ElPudgino/LOS/README.md

# Система мониторинга аэрационной ЛОС

Проект направлен на создание прототипа системы мониторинга аэрационной станции биологической очистки сточных вод для загородного дома. Система должна контролировать поток воды в эрлифтах и давление в воздухных магистралях, передавать показания из станции в дом по радиоканалу, сохранять историю и заранее предупреждать о неполадках.

Главная задача — обнаруживать засоры эрлифтов, снижение производительности компрессоров и нарушение режимов работы до переполнения камер и ухудшения качества очистки. Проектная цель предусматривает автономный влагозащищённый измерительный блок в станции и домашний блок приёма, хранения и анализа данных.

Основное описание целей, требований и существующих аналогов: [scs-project-docs/project.md](scs-project-docs/project.md) и [PDF](scs-project-docs/project.pdf).

## Репозитории

### Документация

| Репозиторий | Назначение |
| --- | --- |
| [scs-project-docs](scs-project-docs/) | Цели и требования проекта, описание системы, обзор аналогов, схемы и проектное предложение. |
| [scs-docs](scs-docs/) | Справочные материалы: документация на микросхемы, датчики и модули, распиновки и другие технические материалы. |

### Прошивки и программное обеспечение

| Репозиторий | Назначение |
| --- | --- |
| [scs-ch32v003-sensor](scs-ch32v003-sensor/) | Bare-metal прошивка CH32V003 для ёмкостного датчика воды в эрлифте: RC-измерения, оценка изменчивости сигнала, энергосбережение и UART. |
| [scs-transmitter-fw-v1](scs-transmitter-fw-v1/) | Прошивка передатчика на Arduino Nano и CC1101: опрос трёх датчиков по UART, проверка CRC и передача измерений и ошибок по радиоканалу. |
| [scs-receiver-fw-v1](scs-receiver-fw-v1/) | Прошивка домашнего приёмника на Arduino Nano и CC1101: приём радиопакетов и выдача телеметрии на компьютер через USB-UART. |
| [scs-frontend](scs-frontend/) | Локальный сервис на Python/FastAPI и веб-интерфейс для сбора телеметрии, хранения истории в SQLite, графиков, статистики и диагностики. |
| [scs-air-valve-arduino](scs-air-valve-arduino/) | Прошивка контроллера воздушного клапана модели септика: управление сервоприводом по состоянию поплавкового датчика. |

### Платы, конструкции и стендовое оборудование

| Репозиторий | Назначение |
| --- | --- |
| [scs-water-sensor-ch32v003](scs-water-sensor-ch32v003/) | Схема и гибкая печатная плата ёмкостного датчика на CH32V003J4M6 с измерительной RC-цепью и интерфейсом UART/SWIO. |
| [scs-transmitter-pcb-v1](scs-transmitter-pcb-v1/) | Плата передатчика: Arduino Nano, CC1101, согласование уровней и подключение трёх датчиков. |
| [scs-receiver-pcb-v1](scs-receiver-pcb-v1/) | Плата приёмника: Arduino Nano, CC1101 и согласователь логических уровней. |
| [scs-air-valve-pcb](scs-air-valve-pcb/) | Плата контроллера воздушного клапана на Arduino Nano с подключением сервопривода, поплавка и питания. |
| [scs-stand-ps](scs-stand-ps/) | Изолированный трансформаторный блок питания стенда: схема, печатная плата и файлы для её изготовления. |
| [scs-3d-models](scs-3d-models/) | Корпуса, крепления и механические узлы датчиков и стенда; исходные 3D-модели и файлы для печати. |

### Инструменты разработки

| Репозиторий | Назначение |
| --- | --- |
| [scs-arduino-ch32v003-swio](scs-arduino-ch32v003-swio/) | Варианты адаптера UART–SWIO на ATmega328P для прошивки и отладки CH32V003 через minichlink. |
| [minichlink](minichlink/) | Сторонний инструмент для прошивки и отладки CH32V003 через WCH-LinkE, включая GDB-сервер и поддержку Ardulink. |
| [arduino-offline](arduino-offline/) | Локальный набор Arduino CLI, Arduino AVR Core и компилятора для автономной сборки Arduino-прошивок. |
