ElPudgino/LOS/scs-air-valve-pcb/README.md

# Контроллер воздушного клапана. Печатная плата

Плата выполнена в KiCAD. Схема в файле [air-valve-pcb.pdf](air-valve-pcb.pdf).

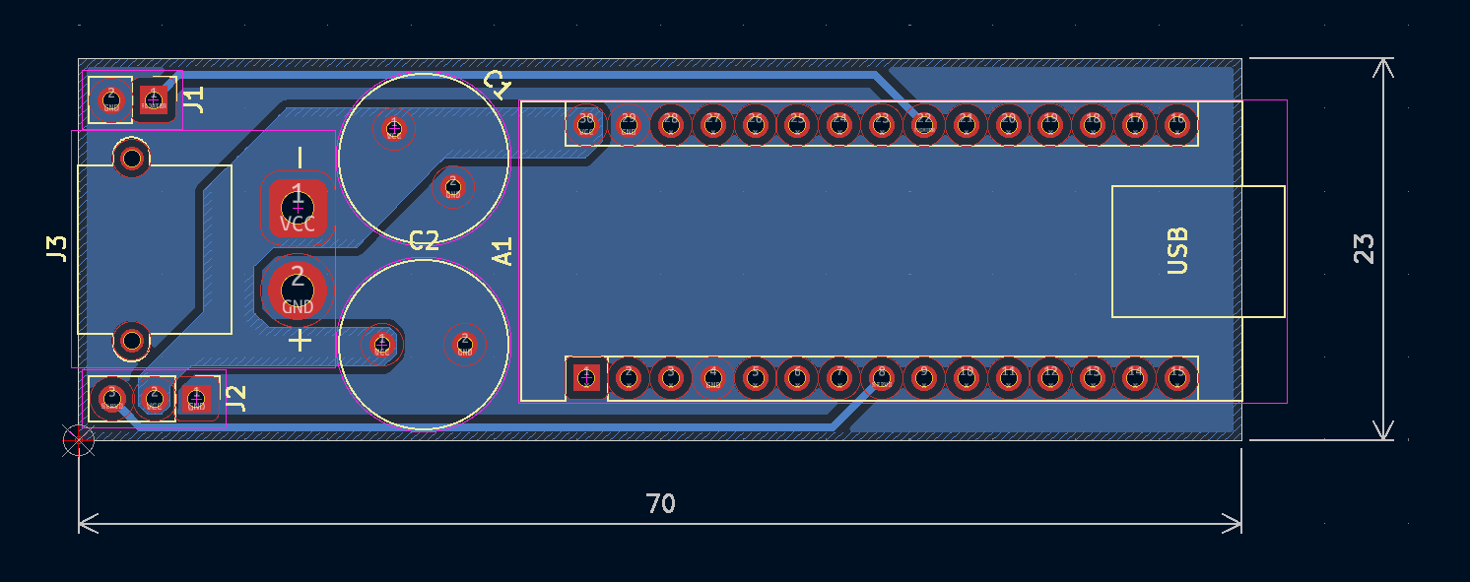
[picture p1: scs-air-valve-pcb/air-valve-pcb.png]
PCB
