ElPudgino/LOS/scs-receiver-fw-v1/README.md

# Приёмник телеметрии SCS

Приёмник SCS принимает в доме телеметрию от датчиков в аэрационной станции очистки сточных вод и передаёт её компьютеру для хранения и анализа.

Передатчик `scs-transmitter-fw-v1` по очереди опрашивает датчики и отправляет накопленные результаты и статусы ошибок по радио. Приёмник на Arduino Nano (ATmega328P) с радиомодулем CC1101 преобразует полученные данные в текст и выдаёт их через USB-подключение Nano.

После включения приёмник настраивает радио и накапливает корректные записи в порядке поступления. Когда в течение секунды нет новых корректных пакетов, он выдаёт накопленную группу между строками BEGIN и END. Так записи объединяются по паузе в передаче. 

Примерно раз в секунду прошивка отправляет строку BEAT, в том числе при недоступном радио. Это признак работы прошивки. При ошибке настройки или связи с радиомодулем приёмник повторяет инициализацию. Повреждённые пакеты и пакеты с неверным форматом отбрасываются целиком. При переполнении буфера вся накопленная группа заменяется сообщением об ошибке; после паузы приём следующей группы продолжается.

Сенсор, передатчик и приёмник должны использовать согласованный бинарный протокол и обновляться комплектом. Пауза между циклами передатчика должна позволять приёмнику разделять группы и завершать их вывод: во время вывода приём может терять пакеты. Повторной передачи и восстановления потерь нет, поэтому группа может быть неполной. Обмен с компьютером идёт по UART **115200, 8N1**; строки заканчиваются одним LF (без CR).

## Подключение

| Nano | CC1101 |
|---|---|
| D2 | GDO0 |
| D10  | CSN |
| D11  | MOSI |
| D12  | MISO |
| D13  | SCK |

Связь с компьютером идёт через штатный USB-UART Nano (D0/D1).

Радиопрофиль: кварц CC1101 26 МГц, 433,92 МГц, 2-FSK, 4,8 кбод, синхрослово D391, переменная длина. Предельный размер полезной нагрузки CC1101 (`Radio::PAYLOAD_SIZE`) составляет 32 байта.  Используется только штатная библиотека `SPI.h`.

## Бинарный радиопротокол

Каждая запись занимает ровно 6 байт и целиком находится в одном RF-пакете:

| Смещение | Поле |
|---|---|
| 0 | `H = (status << 4) | sensor` |
| 1 | `seq`, uint8_t |
| 2-5 | `value_milli`, uint32_t, big-endian |

Допустимые sensor: **1, 2, 3**. Пакет содержит 1-5 записей, то есть
**6, 12, 18, 24 или 30 байт**.

| status | Значение | Строка UART |
|---|---|---|
| 0 | Измерение | `<sensor> <SEQ> <integer>.<fraction>` |
| 1 | Нет ответа | `<sensor> ERR NR` |
| 2 | Таймаут | `<sensor> ERR TO` |
| 3 | Ошибка протокола/CRC сенсора | `<sensor> ERR CR` |
| 4 | Переполнение передатчика | `<sensor> ERR OF` |

У статусов 1-4 поля seq и value_milli игнорируются, даже если не нулевые (передатчик обязан заполнять их нулями). В измерениях SEQ выводится ровно двумя шестнадцатеричными цифрами в верхнем регистре. Значение форматируется целочисленно: `integer = value_milli / 1000`. Дробная часть содержит остаток, ровно три цифры. Числа с плавающей точкой, Arduino String и динамическая память не используются.

```text
01 0A 00 00 00 07  -> 1 0A 0.007
01 FF 00 00 03 E8  -> 1 FF 1.000
01 00 FF FF FF FF  -> 1 00 4294967.295
```

Перед изменением группы проверяется **весь физический RF-пакет**. Некратная 6 длина, неизвестный sensor или status приводят к отбрасыванию всего пакета, включая корректные записи до ошибки. Неизвестный H не превращается в CR: CR выдаётся только по явно полученному status 3. Пустые пакеты и пакеты с плохим аппаратным CRC также игнорируются. Программный CRC поверх радиозаписи не добавляется. Отклонённые пакеты не создают группу, не меняют её данные и не продлевают таймаут. Периодический BEAT и выдача группы по таймауту продолжают работать.

## Группировка, UART и доставка

- После 1000 мс без валидных непустых RF-пакетов группа выдаётся синхронно между `BEGIN\n` и `END\n`. Каждая запись даёт ровно одну строку; общий порядок записей и пакетов сохраняется. Пустая группа не выдаётся.
- На точной границе таймаута накопленная группа выдаётся до обработки нового пакета; новый валидный пакет начинает следующую группу.
- Независимо от состояния радио примерно раз в секунду выдаётся `BEAT\n` (первый через секунду после запуска). Он никогда не вставляется между BEGIN и END. SPI/UART могут немного задерживать BEAT.
- Буфер хранит только бинарные записи: **594 байта** = 3 сенсора * (32 измерения + 1 TO) * 6 байт. Ровно 594 байта принимаются, следующая шестибайтовая запись вызывает переполнение.
- При переполнении вся группа отбрасывается. Последующие валидные пакеты не сохраняются, но продлевают таймаут; протокольно невалидные его не продлевают.  После периода тишины выдаётся только `BEGIN\nERR BO\nEND\n`.  Следующая группа принимается нормально. BO означает переполнение приёмника, OF обозначает статус передатчика. Причиной BO может быть слияние циклов без необходимой паузы или несовпадение конфигураций.
- Переполнение RX FIFO и зависший пакет сбрасывают радиоприём. При ошибке готовности SPI или несовпадении прочитанных настроек инициализация повторяется с интервалом 1 с, без сообщений в UART. Накопленная группа завершается по таймауту.

Пример UART:

```text
BEAT
BEGIN
3 7E 0.117
3 7F 0.125
2 42 0.080
1 ERR NR
END
BEAT
```

## Конфигурация и сборка

Параметры `scs-receiver/config.h`: `BURST_TIMEOUT_MS=1000UL`, `BURST_BUFFER_SIZE=594`. Можно менять их через `EXTRA_FLAGS`.  Проверки при компиляции требуют положительный таймаут меньше 2^31 мс и положительный буфер, кратный 6 и помещающийся в uint16_t. Реальная ёмкость дополнительно ограничена SRAM ATmega328P; нужно оставлять место под стек.

Результаты сборок:

| FQBN | Flash (из 30720 байт) | Статическая SRAM (из 2048 байт) | Остаток под стек и локальные переменные |
|---|---|---|---|
| `arduino:avr:nano` | 4656 | 881 | 1167 |
| `arduino:avr:nano:cpu=atmega328old` | 4656 | 881 | 1167 |

Инструкция по установке зависимостей и сборке находится в [UBUNTU.md](UBUNTU.md). Архив для автономной установки: `arduino-avr-offline-cache.tar.gz`.

Открытие порта компьютером может сбрасывать Nano через DTR.

`make test` проверяет все sensor/status, SEQ 00/0A/FF, значения от нуля до UINT32_MAX, допустимые длины и атомарное отбрасывание неверных пакетов, порядок записей, пустые группы, точное заполнение 594 байт, BO и восстановление, границу таймаута и переполнение счётчика millis().  Интеграционные тесты функции loop() со SPI-моделью проверяют BEAT при недоступном радио, при накоплении и выдаче группы, разделение групп на точной границе, CRC-фильтрацию и отсутствие активности от невалидных пакетов. Тесты драйвера проверяют FIFO, приём, CRC и ограниченные ожидания SPI, порядок GPIO/SPI и задержки при ручном сбросе, запуск и повторную инициализацию, отказ при несовпадении любого конфигурационного регистра или чтении только 00/FF, а также восстановление после ошибки.
