ElPudgino/LOS/scs-water-sensor-ch32v003/README.md

# Схема и плата для датчика потока воды

Датчик построен на базе микроконтроллера CH32V003. Прошивка в папке ../../software/ch32v003-sensor.

Печатная плата выполнена на гибкой полиимидной основе толщиной 0.1мм.
