ElPudgino/LOS/scs-docs/cc1101-arduino-nano.md

| CC1101 Pin | CC1101 Pin name | Arduino Uno/Nano | ESP32 (Default) | Description |
|---|---|---|---|---|
| 2 | VCC | 3.3V | 3.3V | Power Supply (3.3V ONLY!) |
| 1 | GND | GND | GND | Ground |
| 5 | SCK | Pin 13 | GPIO 18 | SPI Clock |
| 7 | MISO | Pin 12 | GPIO 19 | SPI Data Out |
| 6 | MOSI | Pin 11 | GPIO 23 | SPI Data In |
| 4 | CSN / SS | Pin 10 | GPIO 5 | Chip Select |
| 3 | GDO0 | Pin 2 | GPIO 2 | Interrupt/Data Out |
