ElPudgino/LOS/scs-project-docs/docs/analog-research.md

## User
*29/04/2026, 15.33.19*

Ниже описана идея для проекта. Нужно найти аналоги, как коммерческие, так и любительские.

## Assistant
*29/04/2026, 15.33.19*

Ваша идея по созданию системы превентивного мониторинга аэрационных ЛОС является перспективной, так как она переходит от модели «реактивного» реагирования (оповещение о переполнении) к модели «предиктивного» обслуживания (обнаружение отклонений до аварии). Существующие решения на рынке можно разделить на две большие категории: профессиональные промышленные системы и доступные любительские IoT-проекты.

## Коммерческие аналоги (Профессиональные и промышленные системы)

Коммерческие решения ориентированы на крупные муниципальные объекты, промышленные предприятия или высокотехнологичные коммерческие системы очистки [1, 3]. Они характеризуются высокой степенью автоматизации и глубоким анализом параметров.

### Промышленные системы управления и мониторинга
*   **Комплексные системы управления:** Такие компании, как SmartSys Technology, предлагают решения с непрерывным мониторингом в реальном времени, мгновенными оповещениями и мобильным управлением, что позволяет эффективно управлять операциями очистки [1].
*   **Специализированное оборудование для контроля процессов:** Системы от YSI и Hach позволяют отслеживать различные параметры, такие как входящий поток, процессы удаления биогенных веществ (фосфора, азота) и эффективность аэрации [2, 3]. Это помогает снижать затраты на энергию и химикаты [3].
*   **Автоматизация аэрации:** Профессиональные решения (например, от Rockwell Automation или Endress+Hauser) фокусируются на точном контроле уровня кислорода, аммония, нитратов и pH для поддержания оптимальных бактериальных процессов [5, 6, 7]. Это позволяет оптимизировать работу аэрационных бассейнов и интегрировать новые датчики в старое оборудование [6].
*   **Удаленное управление и оптимизация:** Компании вроде Fluence предлагают целые программные комплексы (Smart Operations), которые обеспечивают удаленный мониторинг и оптимизацию производительности в реальном времени, что снижает эксплуатационные расходы в течение жизненного цикла системы [10].

### Решения для частного сектора (бытовой уровень)
*   **GSM-оповещения:** Некоторые производители бытовых станций (например, Юнилос) предлагают GSM-системы оповещения, которые отправляют SMS-сообщения владельцам, если они проживают в загородном доме не постоянно [39].
*   **Базовые датчики:** Существуют модули, предназначенные для септиков, которые могут сообщать о переполнении, измерять мутность, температуру и даже давление воздуха в системе [30]. Однако они чаще всего работают как сигнализаторы критических состояний, а не как системы глубокого анализа работы механизмов.

## Любительские аналоги (DIY и IoT-проекты)

В сегменте DIY (сделай сам) большинство проектов базируется на использовании доступных микроконтроллеров, таких как ESP32 или ESP8266, и направлено на решение узких задач мониторинга [12, 14].

### Мониторинг качества воды и уровней
*   **Контроль химических параметров:** Существует множество проектов по созданию систем мониторинга качества воды с использованием датчиков TDS (общее количество растворенных твердых веществ), pH, мутности и температуры на базе ESP32 [12, 17, 19, 20, 21]. Эти системы позволяют получать данные о состоянии воды через облачные сервисы или веб-интерфейсы [12, 13, 19].
*   **Мониторинг уровня жидкости:** Популярны решения для контроля уровня воды в резервуарах, которые используют ультразвуковые датчики или поплавковые выключатели для отправки уведомлений о заполнении или опустошении емкости через мобильные приложения (например, Blynk) [11, 14, 22].

### Мониторинг технического состояния
*   **Контроль механических систем:** Некоторые энтузиасты создают проекты для мониторинга существующих механических систем, используя ESP32 для логирования данных об использовании и оповещения о сбоях через Wi-Fi [16].
*   **Мониторинг электропитания:** В рамках DIY-проектов контроллеров очистки воды используются схемы для измерения тока в розетках, что позволяет отслеживать постоянную работу воздушных насосов (компрессоров) [18].
*   **Специализированные IoT-устройства:** Разрабатываются системы для мониторинга специфических объектов, таких как пилотные анаэробные биореакторы, где целью является удешевление процесса мониторинга с помощью ESP32 [29].

## Сравнительный анализ и потенциал вашей идеи

Проанализировав рынок, можно выделить ключевое отличие вашей идеи от существующих аналогов:

1.  **Профессиональные системы** слишком дороги и избыточны для частного дома, так как они нацелены на контроль сложных биохимических процессов и муниципальные стандарты [3, 10].
2.  **Любительские проекты** в основном сосредоточены на «поверхностных» показателях: уровне воды [14, 22], качестве воды (pH/TDS) [17, 21] или простом факте работы насоса через потребление тока [18]. Они редко пытаются анализировать именно *внутреннюю механику* работы ЛОС (поток в эрлифтах и динамику давления воздуха).

**Ваша ниша** — это создание «умного диагностического модуля» для бытовых ЛОС. В отличие от любительских датчиков уровня, ваша система будет отслеживать **эффективность передачи энергии и массы** (воздуха и воды) внутри станции. Это позволяет обнаружить засор эрлифта или падение производительности компрессора на этапе, когда биохимические показатели (pH или мутность) еще не успели критически измениться.

### Заключение
Ваш проект может занять промежуточное положение между простым сигнализатором переполнения и дорогой промышленной автоматизацией. Ключом к успеху станет разработка специфических датчиков (потока и давления), которые смогут работать в агрессивной среде ЛОС и предоставлять данные, достаточные для ранней диагностики механических проблем.

**Citations:**
- [1] [https://www.smartsystechnology.com/smart-stp-systems/](https://www.smartsystechnology.com/smart-stp-systems/)
- [2] [https://www.ysi.com/products/wastewater-process-monitors-and-sensors](https://www.ysi.com/products/wastewater-process-monitors-and-sensors)
- [3] [https://www.hach.com/industries/wastewater](https://www.hach.com/industries/wastewater)
- [4] [https://www.norweco.com/commercial/modulair/](https://www.norweco.com/commercial/modulair/)
- [5] [https://www.badgermeter.com/markets/wastewater-treatment/aeration-basins/](https://www.badgermeter.com/markets/wastewater-treatment/aeration-basins/)
- [6] [https://literature.rockwellautomation.com/idc/groups/literature/documents/ap/water-ap026_-en-p.pdf](https://literature.rockwellautomation.com/idc/groups/literature/documents/ap/water-ap026_-en-p.pdf)
- [7] [https://www.mesc.endress.com/en/industry-expertise/water-wastewater/aeration-wastewater-treatment](https://www.mesc.endress.com/en/industry-expertise/water-wastewater/aeration-wastewater-treatment)
- [8] [https://search.abb.com/library/Download.aspx?DocumentID=AN%2FRANDC%2F020-EN](https://search.abb.com/library/Download.aspx?DocumentID=AN%2FRANDC%2F020-EN)
- [9] [https://www.ssiaeration.com/en/accessories/pressure-monitoring-system/](https://www.ssiaeration.com/en/accessories/pressure-monitoring-system/)
- [10] [https://www.fluencecorp.com/wastewater-treatment-solutions/](https://www.fluencecorp.com/wastewater-treatment-solutions/)
- [11] [https://circuitdigest.com/microcontroller-projects/sewage-monitoring-and-maintenance-alert-using-nodemcu-esp8266-and-ultrasonic-sensor](https://circuitdigest.com/microcontroller-projects/sewage-monitoring-and-maintenance-alert-using-nodemcu-esp8266-and-ultrasonic-sensor)
- [12] [https://forum.arduino.cc/t/expert-needed-im-building-a-water-quality-monitoring-system-using-esp32-and-power-bi/1285604](https://forum.arduino.cc/t/expert-needed-im-building-a-water-quality-monitoring-system-using-esp32-and-power-bi/1285604)
- [13] [https://www.reddit.com/r/ArduinoProjects/comments/1f92rfc/monitoring_station_with_iot_to_monitor_water/](https://www.reddit.com/r/ArduinoProjects/comments/1f92rfc/monitoring_station_with_iot_to_monitor_water/)
- [14] [https://www.hackster.io/yaranaiotguru/iot-based-smart-water-level-monitoring-system-using-esp32-de3de2](https://www.hackster.io/yaranaiotguru/iot-based-smart-water-level-monitoring-system-using-esp32-de3de2)
- [15] [https://circuitdigest.com/microcontroller-projects/build-esp32-based-water-monitoring-tool](https://circuitdigest.com/microcontroller-projects/build-esp32-based-water-monitoring-tool)
- [16] [https://github.com/tgolla/AerobicSepticSystemMonitor](https://github.com/tgolla/AerobicSepticSystemMonitor)
- [17] [https://www.hackatronic.com/water-quality-monitoring-system-tds-sensor-esp32-arduino/](https://www.hackatronic.com/water-quality-monitoring-system-tds-sensor-esp32-arduino/)
- [18] [https://hackaday.io/project/160407-diy-wastewater-treatment-controller](https://hackaday.io/project/160407-diy-wastewater-treatment-controller)
- [19] [https://iotprojectsideas.com/iot-water-quality-monitoring-with-tds-sensor-esp32/](https://iotprojectsideas.com/iot-water-quality-monitoring-with-tds-sensor-esp32/)
- [20] [https://how2electronics.com/iot-based-drinking-water-quality-monitoring-with-esp32/](https://how2electronics.com/iot-based-drinking-water-quality-monitoring-with-esp32/)
- [21] [https://randomnerdtutorials.com/esp32-tds-water-quality-sensor/](https://randomnerdtutorials.com/esp32-tds-water-quality-sensor/)
- [22] [https://github.com/abderrahman-laid/ESP32-Water-Monitoring-System](https://github.com/abderrahman-laid/ESP32-Water-Monitoring-System)
- [23] [https://projecthub.arduino.cc/Pedro52/arduino-esp32-diy-water-level-sensor-and-diy-level-indicator-a8d507](https://projecthub.arduino.cc/Pedro52/arduino-esp32-diy-water-level-sensor-and-diy-level-indicator-a8d507)
- [24] [https://www.pantechsolutions.net/sewage-monitoring-and-alert-system-using-esp32](https://www.pantechsolutions.net/sewage-monitoring-and-alert-system-using-esp32)
- [25] [https://www.industrialshields.com/slides/slide/water-treatment-with-esp32-plc-44](https://www.industrialshields.com/slides/slide/water-treatment-with-esp32-plc-44)
- [26] [https://iotcircuithub.com/indoor-plant-watering-system-esp32/](https://iotcircuithub.com/indoor-plant-watering-system-esp32/)
- [27] [https://www.sciencedirect.com/science/article/pii/S2215016123003977](https://www.sciencedirect.com/science/article/pii/S2215016123003977)
- [28] [https://create.arduino.cc/projecthub/chanhj/water-quality-monitoring-system-ddcb43](https://create.arduino.cc/projecthub/chanhj/water-quality-monitoring-system-ddcb43)
- [29] [https://www.mdpi.com/2076-3417/15/1/34](https://www.mdpi.com/2076-3417/15/1/34)
- [30] [https://los-servis.ru/81-wi-fi-gsm-datchiki-dlya-septika](https://los-servis.ru/81-wi-fi-gsm-datchiki-dlya-septika)
- [31] [https://unilos.ru/](https://unilos.ru/)
- [32] [https://septiki-topas.su/septiki/yunilos-astra](https://septiki-topas.su/septiki/yunilos-astra)
- [33] [https://los-servis.ru/](https://los-servis.ru/)
- [34] [http://topas-service.ru/obsluzhivanie-yunilos-astra](http://topas-service.ru/obsluzhivanie-yunilos-astra)
- [35] [https://www.uni-los-astra.ru/](https://www.uni-los-astra.ru/)
- [36] [https://astrapipe.ru/catalog/lokalnye_ochistnye_sooruzheniya_los/septik_yunilos_astra_3_item/](https://astrapipe.ru/catalog/lokalnye_ochistnye_sooruzheniya_los/septik_yunilos_astra_3_item/)
- [37] [https://septik-astra.com/](https://septik-astra.com/)
- [38] [http://obsluzhivanieseptika.ru/obsluzhivanie-septikov](http://obsluzhivanieseptika.ru/obsluzhivanie-septikov)
- [39] [https://sbm-group.ru/products/unilos-astra](https://sbm-group.ru/products/unilos-astra)
- [40] [https://topas-site.ru/blog/ceptik-yunilos-astra-5/](https://topas-site.ru/blog/ceptik-yunilos-astra-5/)
- [41] [https://tisgroup.ru/katalog/septiki/yunilos-astra/](https://tisgroup.ru/katalog/septiki/yunilos-astra/)
- [42] [https://topas-aqua.ru/produktsiya/yunilos/](https://topas-aqua.ru/produktsiya/yunilos/)
- [43] [https://septik1.ru/septiki-yunilos-astra/yunilos-astra-5.html](https://septik1.ru/septiki-yunilos-astra/yunilos-astra-5.html)
- [44] [https://3agorod.ru/s/topas-ili-yunilos-astra/](https://3agorod.ru/s/topas-ili-yunilos-astra/)
- [45] [https://itr-rf.ru/blog/septiki-astra-unilos-kakoy-vybrat-obzor/](https://itr-rf.ru/blog/septiki-astra-unilos-kakoy-vybrat-obzor/)
- [46] [https://www.frear.ru/septik-astra-4.html](https://www.frear.ru/septik-astra-4.html)
- [47] [https://www.topas-moskva.ru/product/astra-200/](https://www.topas-moskva.ru/product/astra-200/)
- [48] [https://topas-aqua.ru/produktsiya/yunilos/astra-4-yunilos/](https://topas-aqua.ru/produktsiya/yunilos/astra-4-yunilos/)
- [49] [https://septicbox.ru/yunilos-astra/74-septik-yunilos-astra-5.html](https://septicbox.ru/yunilos-astra/74-septik-yunilos-astra-5.html)

---
