ElPudgino/LOS/scs-project-docs/docs/deep-research-report.md

# Исследование идеи системы мониторинга аэрационной ЛОС

## Резюме для руководителя

Бриф описывает не просто «приложение», а полноценный edge‑IoT продукт: внутренний датчиковый узел внутри аэрационной ЛОС, радиоканал до дома, домашний блок хранения и анализа, а также интерфейс для предупреждений и просмотра истории. Ключевая ценность идеи — не аварийный сигнал по факту переполнения, а раннее обнаружение деградации режима работы станции по косвенным и прямым признакам: ослаблению потока в эрлифтах, изменению давления воздуха и отклонению циклов работы от накопленной нормы.

На рынке уже есть близкие решения для ЛОС и септиков, но они в основном ловят переполнение, уровень, мутность, концентрацию ила, давление или общие alarm‑события. Публично описанных продуктов, где именно **поток воды в эрлифте** является центральным измеряемым сигналом и где есть **анализ переключения режимов** как отдельная функция, почти не видно. Это и есть главный рыночный зазор идеи.

Лучшие коммерческие ориентиры для изучения — российский **GS BIO‑S5** как локальный baseline по ЛОС, **Septilink SL‑5** как пример сервисной модели для аэрируемых wastewater‑систем, **SepticSitter** как образец раннего предупреждения с историей и подпиской, а также **Aqvify** как сильный пример UX для tank/septic‑monitoring. Лучшие инженерные основания для MVP — self‑hosted стек **Home Assistant + ESPHome** для быстрого локального прототипа и **ThingsBoard CE** для более продуктового IoT‑бэкенда с правилами, тревогами и масштабированием.

Если цель — быстро проверить идею на одном загородном объекте, наиболее рационален локальный MVP: ESP32/ESPHome‑узлы для датчиков, мини‑ПК в доме с Home Assistant или ThingsBoard, и уведомления на телефон. Если цель — будущий коммерческий продукт для сервисных компаний, полезно изучать не только железо и датчики, но и модель монетизации/мониторинга по подписке у Septilink, SepticSitter и Blynk.

## Что именно описано в брифе

Ниже — нормализованная выжимка из прикреплённого брифа. Он описывает ЛОС типа Топас/Юнилос/Астра, раннее выявление сбоев по данным датчиков, радиоканал между станцией и домом, домашний анализ данных и интерфейс, доступный с телефона или компьютера.

| Категория | Что зафиксировано в брифе | Степень определённости |
|---|---|---|
| Основная задача | Предупреждать о признаках неисправности **до** аварийного переполнения | Явно задано |
| Ключевые входные данные | Поток воды в эрлифтах, давление воздуха в магистралях компрессора, статистика режимов работы, история переключений | Явно задано |
| Ключевые функции | Непрерывный мониторинг, сбор статистики, выявление отклонений, ранние уведомления, будущие рекомендации по причине и обслуживанию | Явно задано |
| Пользовательские потоки | Монтаж → сбор показаний → передача данных → анализ отклонений → предупреждение → обслуживание → наблюдение за восстановлением после чистки | Частично явно, частично выведено из брифа |
| Основная аудитория | Владельцы загородных домов с аэрационной ЛОС | Частично задано |
| Вторичная аудитория | Сервисные компании / монтажники / техобслуживание | Подразумевается, но не зафиксировано как отдельная роль |
| Платформы | Домашний блок может быть отдельным устройством с экраном, мини‑компьютером, домашним сервером или веб‑интерфейсом | Частично задано |
| Mobile | Доступ с телефона упомянут, но тип клиента не уточнён | Частично задано |
| Web | Веб‑интерфейс прямо упомянут | Явно задано |
| Desktop | Доступ с компьютера упомянут, но отдельный desktop‑клиент не описан | Частично задано |
| Native mobile app | Не описан отдельно | Не указано |
| Native desktop app | Не описан отдельно | Не указано |
| Локальность хранения | Домашний блок приёма, хранения и анализа данных прямо предусмотрен | Явно задано |
| Cloud | Обязанность или необходимость облака не описаны | Не указано |
| Радиосвязь | Передача по радиоканалу, ориентировочно до 30 м | Явно задано |
| Питание внутреннего блока | Желательна автономность на аккумуляторе/батарее | Явно задано |
| Технические ограничения | Влажная и агрессивная среда, загрязнение/отложения, низкое энергопотребление, устойчивость датчиков, стабильная связь, безопасное размещение электроники | Явно задано |
| Tech stack | Конкретный стек, MCU, протокол, БД, язык, ОС, типы датчиков потока — не названы | Не указано |

Ключевой продуктовый вывод из этого блока: идея намного ближе к **«системе мониторинга состояния процесса»**, чем к обычной alarm‑сигнализации. Это важно, потому что аналогов уровня «датчик переполнения + push» уже немало, а аналогов уровня «edge‑диагностика процесса аэрационной ЛОС» заметно меньше.

## Как велось исследование

В исследовании сначала были выделены явные требования из брифа, затем рынок был разбит на два слоя: **прямые аналоги** для ЛОС/септиков и **инфраструктурные аналоги** — платформы, на которых можно быстро собрать подобный продукт. Источники отбирались с приоритетом: русскоязычные страницы производителей, затем официальные сайты продуктов, страницы магазинов приложений при необходимости и репозитории на. Для оценки брались не только функции, но и зрелость, лицензирование, режим поставки, модель монетизации и пригодность к форку/быстрому MVP.

```mermaid
flowchart LR
    A[Бриф пользователя] --> B{Что задано явно?}
    B --> C[Функции, ограничения, платформа]
    B --> D[Пометка "не указано"]
    C --> E[Прямые аналоги ЛОС и септиков]
    C --> F[Платформенные IoT аналоги]
    E --> G{Критерии отбора}
    F --> G
    G --> G1[Раннее предупреждение]
    G --> G2[Уровень, поток, давление]
    G --> G3[История и отклонения]
    G --> G4[Уведомления]
    G --> G5[Локальный хаб или self-host]
    G --> G6[Цена или лицензия]
    G --> G7[Зрелость и пригодность к форку]
    G --> H[Shortlist лучших совпадений]
```

## Коммерческие аналоги

Коммерческий слой делится на две группы. Первая — это **прямые продукты для септиков/ЛОС**, где уже есть датчики, уведомления и иногда облачный мониторинг. Вторая — **коммерческие IoT‑платформы**, которые не решают доменную задачу сами по себе, но позволяют быстро упаковать её в приложение и сервис. Поиск показал, что именно в сегменте direct products сильнее всего представлены уровень, переполнение, давление воздуха и исторические графики; явного публичного акцента на потоке воды в эрлифте почти нет.

| Аналог | Платформа | Что это | Совпадение с идеей | Цена / лицензия | Целевая аудитория | Зрелость | Плюс / минус | Источники |
|---|---|---|---|---|---|---|---|---|
| [GS BIO‑S5](https://los-servis.ru/81-wi-fi-gsm-datchiki-dlya-septika) | Wi‑Fi/GSM + смартфон | Российский модуль мониторинга аэрационных септиков | Совпадает по раннему предупреждению, уровню, мутности/илу, температуре и **давлению воздуха**; нет публично заявленного контроля **потока в эрлифте** и глубокой anomaly‑аналитики | ~19 560 ₽; проприетарный продукт | Владельцы Топас/Юнилос/Астра/БиоДека, сервис | Активен, товар в продаже | **Плюс:** очень близкий российский baseline. **Минус:** ближе к supervisory monitoring, чем к process analytics |  |
| [GS AIR CONTROL BOX](https://sszolotar.ru/monitoring-ak/avtonomnaya-kanalizatsiya-datchiki-udalennogo-monitoringa-aeratsionnoj-ustanovki) | GSM / сервер / web | Модуль удалённого мониторинга и управления аэрационной установкой | Совпадает по уровню, температуре, илу, **давлению компрессора**, серверной передаче и частичному управлению; нет явного контроля потока в эрлифтах | Цена публично не указана; проприетарный продукт | Владельцы и сервис аэрируемых ЛОС | Скорее нишево активен, но публичный след выглядит старее | **Плюс:** близок по домену и логике ЛОС. **Минус:** публичная реализация выглядит устаревшей и с интервалом передачи 30 минут |  |
| [Septilink SL‑5 / SL Connect](https://www.septilink.com/) | Облако + app + web | Стартап для удалённого мониторинга pumps и aerator‑equipped wastewater systems | Хорошо совпадает по раннему предупреждению, app‑интерфейсу и «service model»; публично не раскрывает конкретный sensor stack до уровня flow/pressure per airlift | Публичной цены на основном сайте нет; проприетарный продукт | Домовладельцы и wastewater‑профи | Активный стартап | **Плюс:** один из самых близких продуктовых ориентиров. **Минус:** мало публичной инженерной детализации |  |
| [SepticSitter](https://septicsitter.com/how-it-works/) | Датчики + online dashboard + подписка | Система раннего предупреждения для onsite sewage systems | Совпадает по раннему предупреждению, истории, dashboard, подписке и pro‑maintenance; сенсоры в основном non‑contact level/field monitoring, а не airlift flow | От ~US$959 / CA$1 495 за base system в публичных страницах; есть платный monitoring plan | Владельцы септиков и сервис‑провайдеры | Активен | **Плюс:** сильная модель “alerts + history + service”. **Минус:** не про внутреннюю process‑диагностику аэрационной ЛОС |  |
| [Aqvify](https://aqvify.com/tank/) | Сенсор + box + iOS/Android app | App‑ориентированный мониторинг tank/septic/wastewater levels | Совпадает по уровню, истории, inflow/fill‑rate, тревогам и UX; не специализирован под эрлифты и режимы аэрации | От 537 EUR incl. VAT; 1 год включён, далее 99 EUR/год или 9.9 EUR/мес | Дом, фермы, сообщества, объекты с резервуарами | Активен | **Плюс:** один из лучших UX‑референсов для «уровень + история + тревоги». **Минус:** это tank monitoring, а не диагностика логики ЛОС |  |
| [Blynk](https://www.blynk.io/pricing) | SaaS, mobile/web, white‑label | Коммерческая low‑code IoT‑платформа | Совпадает как упаковочный слой: dashboards, automations, analytics, white‑label apps, поддержка разных сетей; не даёт доменной логики ЛОС «из коробки» | Free $0; Starter $29/мес; Pro/Enterprise масштабируются по объёму и брендингу | Стартапы, продуктовые команды, IoT‑компании | Активен | **Плюс:** быстрое доведение до app‑опыта. **Минус:** cloud‑first; локальный self‑host доступен не как базовый сценарий |  |

Самый важный вывод по коммерческому слою: российские прямые решения уже показывают, что рынок понимает ценность **давления воздуха**, **уровня** и remote alerts, но коммерческий сегмент пока выглядит ближе к «охране установки», чем к «диагностике режима очистки». Зарубежные решения сильнее в app‑UX, истории и сервисной монетизации, но тоже чаще вращаются вокруг level monitoring и pump/aerator alarms, а не around flow‑sensing в эрлифтах.

## Open-source и hobbyist аналоги

Open‑source и hobbyist слой полезен не как «готовый конкурент», а как набор строительных блоков. Здесь есть зрелые системы для локального хаба, правил, dashboards и firmware для ESP32‑узлов, а также несколько очень близких DIY‑проектов именно для septic‑monitoring. Этот пласт особенно важен, если требуется быстрый прототип без жёсткой зависимости от облака.

| Аналог | Платформа | Что это | Совпадение с идеей | Цена / лицензия | Целевая аудитория | Зрелость | Плюс / минус | Источники |
|---|---|---|---|---|---|---|---|---|
| [Home Assistant](https://www.home-assistant.io/) | Локальный сервер + mobile/web/desktop dashboards | Self‑hosted платформа для автоматизации и интерфейсов | Совпадает по локальному хранению, dashboards, уведомлениям, mobile/desktop доступу и быстрому MVP в доме | Бесплатно; Apache‑2.0 | DIY, integrators, power users | Очень активен | **Плюс:** лучший local‑first UX для домового хаба. **Минус:** не специализирован под fleet‑telemetry и process analytics ЛОС |  |
| [ESPHome](https://esphome.io/) | Firmware для ESP32/ESP8266/BK72xx/RP2040 | YAML‑ориентированная прошивка для датчиков и actuator‑узлов | Совпадает как самый быстрый путь к pressure/flow/level sensor nodes и OTA‑обновлениям | Бесплатно; смешанная лицензия MIT + GPLv3 | Makers, инженеры прототипов | Очень активен | **Плюс:** резко ускоряет sensor prototyping. **Минус:** сам по себе не даёт продуктовый бэкенд и пользовательскую аналитику |  |
| [ThingsBoard CE](https://thingsboard.io/docs/) | Self‑hosted web IoT platform | Open‑source IoT backend: device management, data collection, processing, visualization | Очень хорошо совпадает по telemetry backend, rules, alerts, dashboards и историческим данным | Бесплатно; Apache‑2.0 | Стартапы, IoT‑команды, IIoT | Активен | **Плюс:** сильнейшая основа под продуктовый backend. **Минус:** тяжелее в развёртывании, чем Home Assistant |  |
| [WiFi‑Septic‑Controller](https://github.com/mikelawrence/WiFi-Septic-Controller) | Custom PCB + MQTT + Home Assistant | DIY‑контроллер для aerobic septic system | Очень близок по домену: separate inputs для **air pressure failure**, high level, bleach alarm; видимость pump runs; MQTT в Home Assistant | Бесплатно; MIT | Advanced DIY / инженеры‑самодельщики | Нишевой, но содержательный | **Плюс:** лучший открытый reference по septic‑hardware уровня alarm/process. **Минус:** это mains‑PCB с высокой электрической сложностью, а не battery‑edge node |  |
| [WaterFlowKit](https://github.com/smarthomeshop/waterflowkit) | ESPHome + Home Assistant, Wi‑Fi/Ethernet | Нишевый flow‑monitor для воды с локальной интеграцией | Не септик‑специфичен, но сильнее всего совпадает по **измерению потока**, локальной работе и калибровке датчиков | Код под CC BY‑NC 4.0; hardware‑цена публично в найденных страницах не зафиксирована | Smart‑home DIY / makers | Активный нишевой продукт | **Плюс:** лучший шаблон sensor‑layer для flow telemetry. **Минус:** лицензия некоммерчески ограничивает прямой форк |  |
| [Topas Meter gist](https://gist.github.com/aver-ua/1d111b006ab88692ea070cf33ffeead8) | ESP32 + ESPHome + Home Assistant | Русскоязычный/региональный hobby‑пример для Топас: температура + уровень | Совпадает как очень близкий локальный пример для owner‑operated monitoring ЛОС; датчика потока и сложной аналитики нет | Бесплатно; лицензия не указана | DIY‑владельцы Топас | Низкая активность | **Плюс:** локально‑рыночный и очень предметный reference. **Минус:** узкий охват, нет ясного лицензирования и продуктовой зрелости |  |

Главный практический вывод по open‑source слою такой: для быстрого прототипа у идеи уже есть все нужные кирпичи — датчиковая прошивка, локальный хаб, alerts, графики, MQTT и примеры именно для septic‑тематики. Не хватает не инфраструктуры, а **специфического доменного know‑how**: устойчивого к загрязнению flow‑сенсора в эрлифте, модели нормального цикла для конкретной ЛОС и правил, которые отличают «шум режима» от настоящего предаварийного отклонения.

## Сводное сравнение

Ниже — сравнение всех отобранных аналогов по тому, насколько полно они покрывают именно вашу идею, а не просто любую систему датчиков.

| Аналог | Тип | Покрытие идеи | Цена / лицензия | Платформа | Зрелость | Источники |
|---|---|---|---|---|---|---|
| GS BIO‑S5 | Коммерческий, direct | **Высокое‑**: уровень, ил/мутность, давление, alerts; нет явного flow‑sensing в эрлифте | ~19 560 ₽; проприетарно | Wi‑Fi/GSM + smartphone | Активен |  |
| GS AIR CONTROL BOX | Коммерческий, direct | **Средне‑высокое**: уровень, ил, давление, серверный мониторинг, частичное управление | Цена не указана; проприетарно | GSM/server/web | Нишевой / публично выглядит старее |  |
| Septilink SL‑5 | Коммерческий, direct | **Высокое**: very close domain fit, app, instant alerts, pumps + aerators | Цена публично не раскрыта | App + cloud/web | Активен |  |
| SepticSitter | Коммерческий, direct | **Средне‑высокое**: раннее предупреждение + история + подписка, но sensor model mainly level‑centric | От US$959 / CA$1 495 + plan | Sensors + dashboard | Активен |  |
| Aqvify | Коммерческий, adjacent | **Среднее**: сильный UX, alarms, history, inflow, но tank monitoring rather than aeration logic | От 537 EUR + 99 EUR/год | Sensor + app | Активен |  |
| Blynk | Коммерческий SaaS | **Среднее**: упаковывает продукт, но не даёт доменную логику ЛОС | $0 / $29+ / custom | Mobile/web/cloud | Активен |  |
| Home Assistant | Open source platform | **Средне‑высокое** для local MVP: dashboards, alerts, mobile/desktop | Apache‑2.0 | Local server + mobile/web | Очень активен |  |
| ESPHome | Open source firmware | **Среднее**: sensor‑node слой, OTA, fast prototyping | MIT + GPLv3 | ESP‑firmware | Очень активен |  |
| ThingsBoard CE | Open source platform | **Высокое** для backend: telemetry, rules, dashboards, alerts | Apache‑2.0 | Self‑hosted web | Активен |  |
| WiFi‑Septic‑Controller | Hobbyist, direct | **Средне‑высокое**: closest open septic hardware reference | MIT | Custom PCB + MQTT | Нишевой |  |
| WaterFlowKit | Open hardware/software adjacent | **Среднее**: strong flow layer, weak septic domain | CC BY‑NC 4.0 | ESPHome + HA | Активный нишевой |  |
| Topas Meter gist | Hobbyist, direct | **Ниже среднего**: близкий owner use case, но узкий функционал | Лицензия не указана | ESPHome + HA | Низкая активность |  |

Из этого сравнения видно, что идею лучше мыслить как **синтез трёх слоёв**. Первый слой — доменные референсы по ЛОС и septic monitoring, которые подсказывают, что пользователи уже готовы платить за alerts, history и service visibility. Второй слой — local/home IoT‑стек для MVP. Третий — специализированный sensor‑layer для потока в эрлифте и air/flow correlation, которого в публичных аналогах почти нет. Именно третий слой и является основным интеллектуальным активом будущего продукта.

Для визуальной калибровки полезно сравнить, как выглядят российский direct‑product, зарубежный septic‑app, tank‑monitoring UX и open‑source dashboard‑подход.

## Лучшие совпадения и рекомендация

Ниже — shortlist из восьми наиболее полезных совпадений. Здесь сознательно смешаны direct competitors, app/UX‑референсы и open‑source bases, потому что задача состоит не только в сравнении готовых конкурентов, но и в выборе того, **что изучать**, а **что разумно форкать или брать за основу**.

| Лучший матч | Почему это сильное совпадение | Изучать или форкать | Почему именно так | Источники |
|---|---|---|---|---|
| GS BIO‑S5 | Самый близкий российский baseline по ЛОС: уже есть давление воздуха, уровень и push‑логика | **Изучать** | Это ориентир по локальному рынку, формулировкам ценности и набору «must‑have» датчиков, но не открытая база для форка |  |
| Septilink SL‑5 | Очень близок к продуктовой идее для aerator‑equipped wastewater systems | **Изучать** | Полезен как reference по packaging, app‑UX и сервисной модели «homeowner + service provider» |  |
| SepticSitter | Лучший пример «раннее предупреждение + история + подписка + обслуживание» | **Изучать** | Сильный референс для retention, subscription logic и maintenance workflow, но не для sensor innovation в эрлифте |  |
| Aqvify | Сильный эталон app‑UX для уровней, истории и тревог | **Изучать** | Полезен для проектирования UI и onboarding, даже если домен уже более tank‑centric, чем LOS‑centric |  |
| ThingsBoard CE | Самый зрелый open‑source backend под телеметрию, правила, тревоги и графики | **Строить поверх / форкать** | Лучший кандидат, если цель — продукт с несколькими объектами, аналитикой и долгой историей |  |
| Home Assistant + ESPHome | Самый быстрый local‑first MVP для одного дома | **Строить поверх / форкать частично** | Идеален для пилота: дешёвый, понятный, локальный, с быстрым выводом датчиков и алертов на телефон |  |
| WiFi‑Septic‑Controller | Лучший открытый железный reference именно под aerobic septic | **Изучать и частично реиспользовать идеи** | Полезен для схемотехники входов аварий, pressure/high‑level sensing и MQTT‑интеграции; не копировать слепо из‑за архитектуры mains‑PCB |  |
| WaterFlowKit | Лучший reference по sensor‑layer для потока воды | **Изучать; форк осторожно** | Полезен для flow telemetry, калибровки и local integration, но лицензия CC BY‑NC 4.0 неудобна для прямого коммерческого реюза |  |

Итоговая рекомендация выглядит так. Если цель — **пилот на одном объекте**, наиболее рационален стек **ESPHome + Home Assistant**, а в качестве инженерных шпаргалок стоит разбирать **WiFi‑Septic‑Controller**, **WaterFlowKit** и **Topas Meter**. Если цель — **будущий коммерческий продукт с несколькими объектами и сервисной моделью**, то backend стоит строить на **ThingsBoard CE**, коммерческую упаковку изучать у **Septilink**, **SepticSitter** и **Aqvify**, а локальный российский benchmark держать по **GS BIO‑S5**.

Самая важная аналитическая концовка исследования: **рыночная ниша не в ещё одном «датчике септика», а в process‑monitoring для аэрационной ЛОС** — то есть в сочетании устойчивых к загрязнению сенсоров, локального анализа режима, ранней тревоги по отклонению от нормального цикла и объяснимых рекомендаций по обслуживанию. Готовые продукты на рынке уже доказали спрос на alerts и history, а зрелые open‑source платформы снимают половину инженерного риска. Но доменная часть — **flow sensing в эрлифте + correlation с воздухом + detection of wrong switching modes** — остаётся главным участком, где идея действительно отличается от найденных аналогов.
