ElPudgino/LOS/scs-project-docs/docs/analog-research-chat.md

Я провел поиск по российским и зарубежным источникам, чтобы найти максимально близкие аналоги вашей идее.

**Краткий вывод:** Прямого коммерческого продукта для частного сектора, который бы мониторил именно **потоки в эрлифтах и давление воздуха для предиктивного анализа**, на рынке практически нет. Большинство существующих решений либо слишком простые (реактивные), либо слишком сложные (промышленные).

Вот детальный разбор найденных аналогов по категориям:

### 1. Потребительские решения (Производители ЛОС)
Большинство популярных систем (Топас, Астра, Юнилос и др.) используют стандартный подход:
*   **Функционал:** Автоматика на базе ПЛК (программируемых логических контроллеров), которая работает по таймеру.
*   **Мониторинг:** Ограничен «аварийным сигнализатором» (поплавковый датчик), который срабатывает только при переполнении камеры.
*   **Вердикт:** Это **реактивные системы**. Они сообщают о катастрофе, которая уже произошла, но не следят за «здоровьем» системы (засорением трубок).

### 2. Любительские и DIY-решения (Smart Home / IoT)
На форумах (ForumHouse, Reddit r/smarthome) встречаются попытки автоматизировать септики:
*   **Что делают:** Устанавливают ультразвуковые датчики уровня жидкости (например, на базе ESP32 или Arduino) и выводят данные в Home Assistant.
*   **Цель:** Получать уведомление на телефон, когда уровень воды в септике поднимается выше нормы.
*   **Вердикт:** Это **частичные аналоги**. Они реализуют вашу идею по передаче данных в дом и уведомлениям, но следят только за *уровнем*, а не за *процессом* (потоками и давлением).

### 3. Промышленные системы (Wastewater IoT / SCADA)
В муниципальных очистных сооружениях и на заводах используются системы класса SCADA и IoT-платформы для предиктивного обслуживания (Predictive Maintenance).
*   **Что делают:** Устанавливают промышленные расходомеры, датчики дифференциального давления и анализаторы состава воды. Системы анализируют отклонения от нормы и предсказывают износ оборудования или засоры.
*   **Вердикт:** Это **функциональные аналоги**. Технологически они делают именно то, что вы задумали, но они рассчитаны на огромные бюджеты и масштабы города, а не на загородный дом.

### Сводная таблица анализа

| Тип системы | Что мониторит | Когда сообщает | Доступность |
| :--- | :--- | :--- | :--- |
| **Штатная автоматика** | Поплавок (уровень) | Когда переполнилось | Встроено в ЛОС |
| **DIY / Smart Home** | Ультразвук (уровень) | Когда уровень критичен | Самосбор |
| **Промышленные IoT** | Потоки, давление, pH | Задолго до сбоя | Очень дорого |
| **Ваш проект** | **Потоки эрлифтов $\rightarrow$ Давление $\rightarrow$ Статистика** | **При первых признаках засора** | **Ниша свободна** |

### Резюме для вашего проекта:
Ваш проект находится в «золотой середине». Вы берете **промышленный подход** (предиктивный анализ через давление и потоки) и переносите его в **потребительский сегмент** (доступная электроника, радиоканал до 30м, домашний интерфейс).

**Главный вывод из поиска:** Отсутствие готовых бытовых систем такого типа подтверждает актуальность вашей идеи. Основным «конкурентом» для вас будет не другой продукт, а привычка пользователей игнорировать станцию до тех пор, пока она не переполнится.

### Ссылки

- https://3agorod.ru/s/lokalnye-ochistnye-sooruzheniya-dlya-doma/
- https://binteq-group.kg/wp-content/uploads/2024/06/pasport-instrukcziya-po-ekspluataczii-topas-3-m3.pdf
- https://deka.ru/catalog/genesis/https://www.sciencedirect.com/science/article/abs/pii/S2211285523002562
- https://www.reddit.com/r/smarthome/comments/eh6z48/smart_sewer_monitor/
- https://www.waterboards.ca.gov/waterrights/water_issues/programs/diversion_use/wm_vendors.html
- https://los-servis.ru/remont-i-obsluzhivanie-septikov-v-vsevolozhske/134-obsluzhivanie-yunilos-astra.html
- https://www.topas-moskva.ru/product/astra-5/
- https://3agorod.ru/s/yunilos-astra-4-printsip-raboty/
- https://kcftech.com/case-study/scada-iot-predictive-maintenance/
- https://www.sciencedirect.com/science/article/pii/S2214714424007189
- https://www.digi.com/blog/post/iot-in-asset-monitoring-and-predictive-maintenance
