ElPudgino/LOS/scs-project-docs/docs/brief.md

# Система мониторинга аэрационной станции очистки

Аэрационная ЛОС - это локальное очистное сооружение для загородного дома. К таким установкам относятся станции типа Топас, Юнилос, Астра и другие системы биологической очистки сточных вод.

Работа ЛОС основана на последовательной механической и биологической очистке. Сначала из стоков отделяются крупные и твёрдые частицы, затем органические загрязнения разлагаются аэробными бактериями с участием активного ила, после чего вода проходит дополнительные этапы очистки. В результате установка может удалять до 98% загрязнений, превращая бытовые стоки в техническую воду.

Внутри станции несколько камер. Между ними вода перекачивается с помощью эрлифтов - насосов, которые поднимают жидкость за счёт воздуха, подаваемого в погружённую трубу. В камерах также установлены аэраторы: они насыщают воду кислородом и создают условия для жизни аэробных бактерий.

У станции есть разные режимы работы: меняются направления перекачки, включаются и отключаются аэраторы. От того, насколько правильно и своевременно переключаются эти режимы, напрямую зависит качество очистки.

## Проблема

Во время работы внутри трубок и шлангов эрлифтов постепенно накапливаются отложения. Со временем они могут частично или полностью перекрыть поток воды. Из-за этого нарушается нормальный режим работы станции.

Последствия могут быть разными: ухудшение качества очистки, вынос ила на выходе, переполнение камер, а в худшем случае - затопление блока управления и компрессоров.

Обычно в таких станциях установлен штатный аварийный сигнализатор, но он срабатывает только при переполнении. Проблема в том, что сбои начинаются намного раньше. Станция может уже работать неправильно, хуже очищать воду и выбрасывать недоочищенные стоки, но пользователь об этом ещё не знает.

Даже после чистки установка не всегда сразу возвращается к нормальному режиму. Иногда ей требуется несколько недель, чтобы снова выйти на стабильную работу.

## Идея решения

Предлагается создать систему мониторинга аэрационной ЛОС. Она должна отслеживать фактическую работу станции и заранее сообщать о признаках неисправности - ещё до аварийного переполнения.

Система может включать:

- датчики потока воды в эрлифтах;
- датчики давления воздуха в магистралях компрессоров;
- электронный блок сбора данных внутри станции;
- блок приёма, хранения и анализа данных в доме.

Датчики и блок сбора данных размещаются внутри станции. Они должны регулярно считывать показания и передавать их по радиоканалу на основной блок, расположенный в доме. Ориентировочная дальность передачи - до 30 метров, то есть в пределах типичного загородного участка.

Для безопасности внутренний блок желательно сделать автономным: с питанием от аккумулятора или батарей. Это снизит риски, связанные с размещением электроники во влажной среде.

Блок приёма и анализа может быть реализован по-разному: как отдельное устройство с экраном и кнопками, как мини-компьютер, как домашний сервер или как веб-интерфейс, доступный с телефона или компьютера.

## Что должна делать система

Система должна непрерывно следить за режимом работы станции, собирать статистику и выявлять отклонения.

Например, она сможет определить, что:

- поток воды в одном из эрлифтов стал слабее обычного;
- давление воздуха изменилось по сравнению с нормальным режимом;
- переключение режимов происходит неправильно;
- работа станции стала отличаться от накопленной статистики за предыдущие периоды.

При обнаружении отклонений система должна заранее предупредить пользователя. Это позволит провести обслуживание до того, как возникнет переполнение, ухудшится качество очистки или выйдет из строя оборудование.

В дальнейшем, на основе накопленных данных, можно добавить интеллектуальный анализ: система сможет не только фиксировать проблему, но и подсказывать вероятную причину и рекомендовать действия по обслуживанию станции.

## Основные задачи разработки

- Разработать датчики потока воды для эрлифтов, устойчивые к загрязнениям и отложениям.
- Обеспечить надёжную работу датчиков и электроники во влажной среде внутри станции.
- Подобрать элементную базу и схемные решения с низким энергопотреблением.
- Рассчитать достаточное время автономной работы от аккумуляторов или батарей.
- Организовать стабильную радиосвязь между станцией и домом на расстоянии до 30 метров.
- Разработать программное обеспечение для сбора, передачи, хранения и анализа данных.
- Реализовать систему уведомлений о сбоях и отклонениях в работе ЛОС.
