ElPudgino/LOS/scs-docs/TP1201.pdf

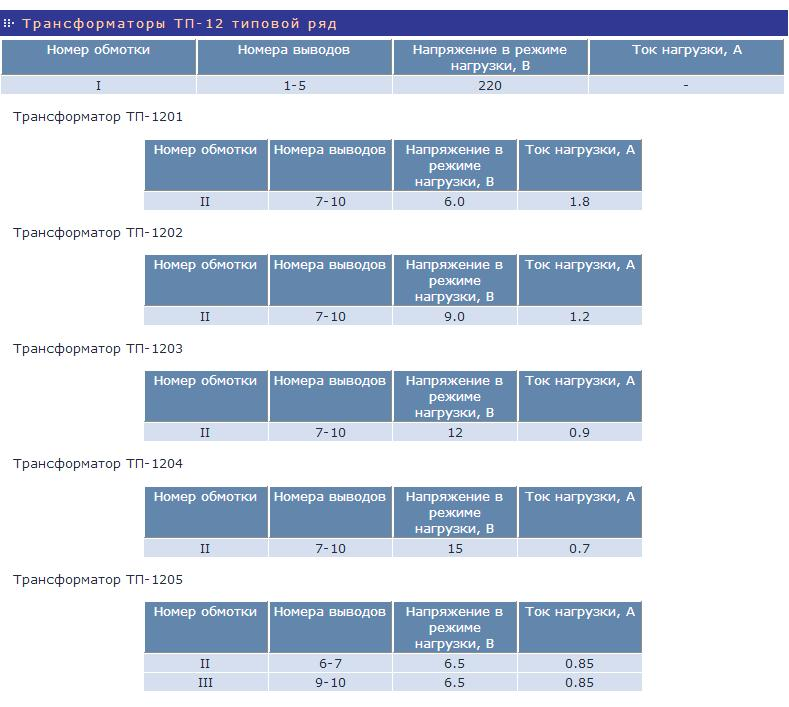
[picture p7: page 1]
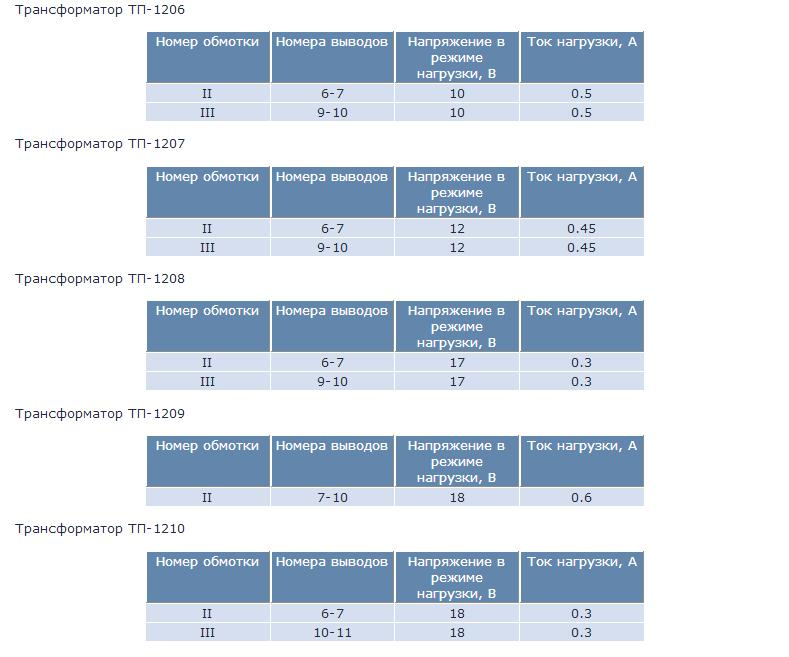
[picture p8: page 2]
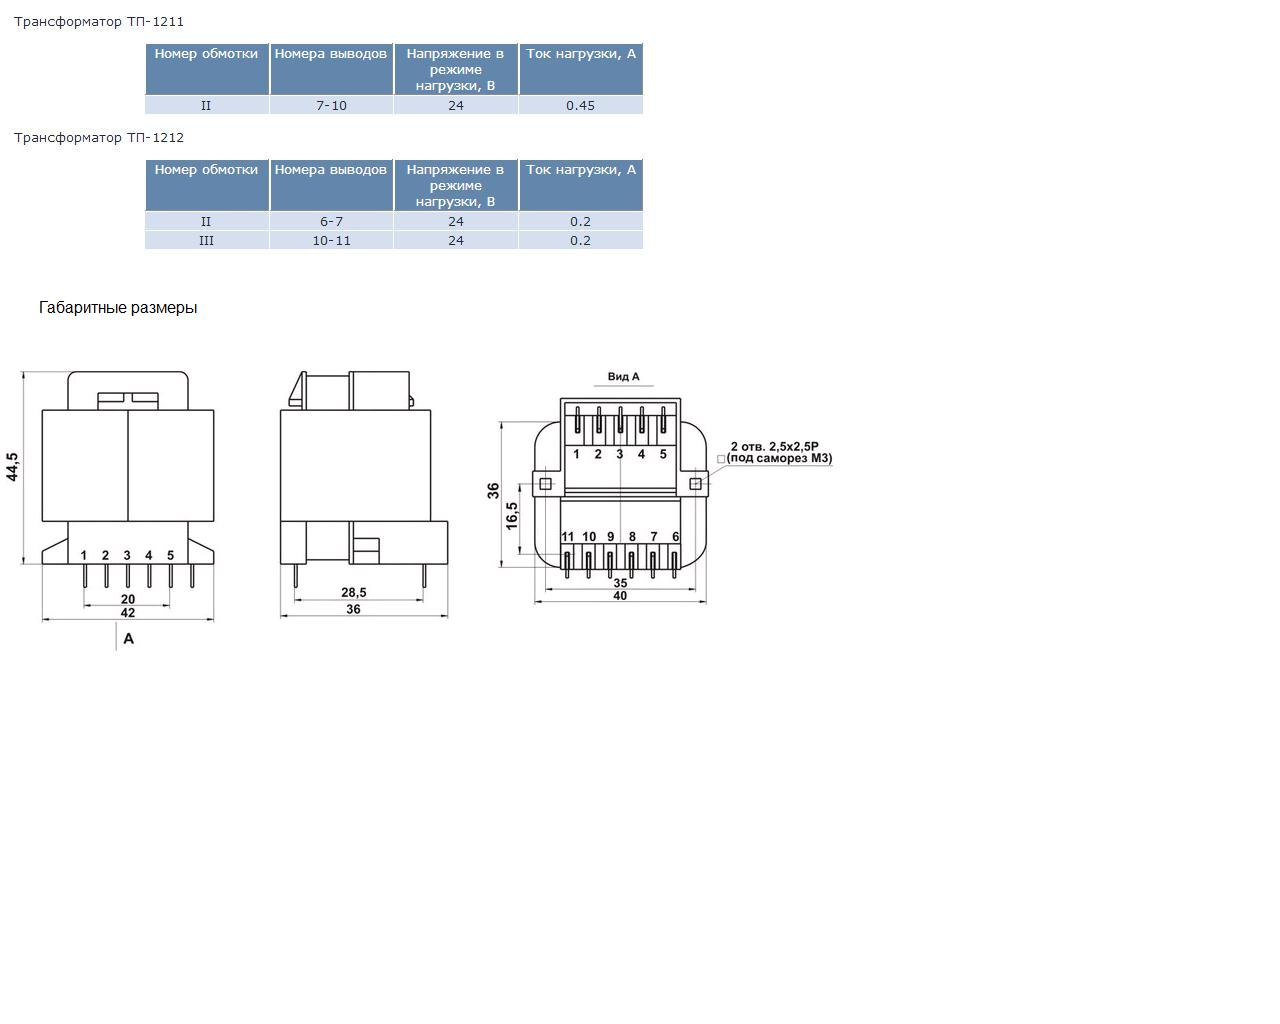
[picture p9: page 3]
