ElPudgino/LOS/scs-air-valve-pcb/photo/photo-1.jpg

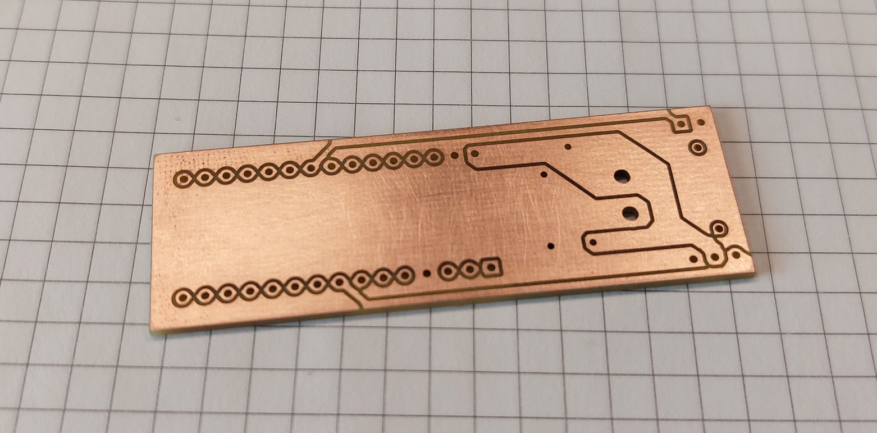
scs-air-valve-pcb/photo/photo-1.jpg
