ElPudgino/LOS/scs-air-valve-pcb/photo/photo-2.jpg

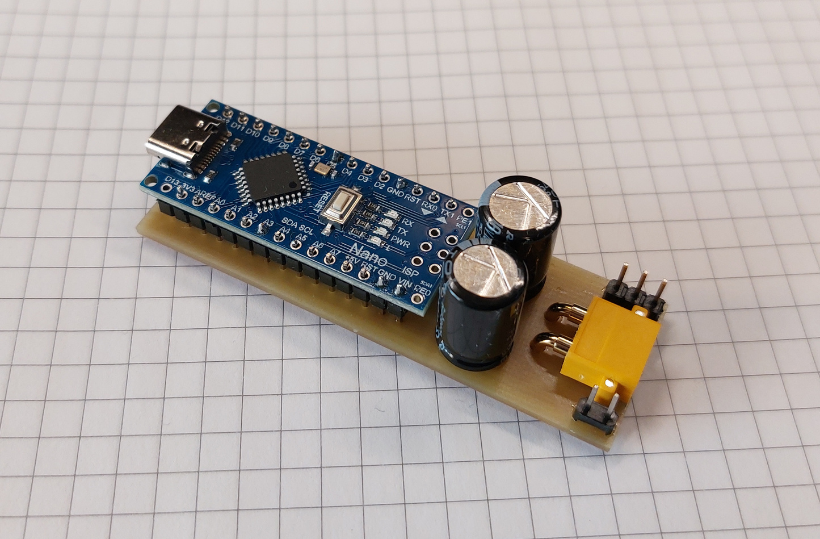
scs-air-valve-pcb/photo/photo-2.jpg
