ElPudgino/LOS/scs-docs/cc1101-pinout.jpg

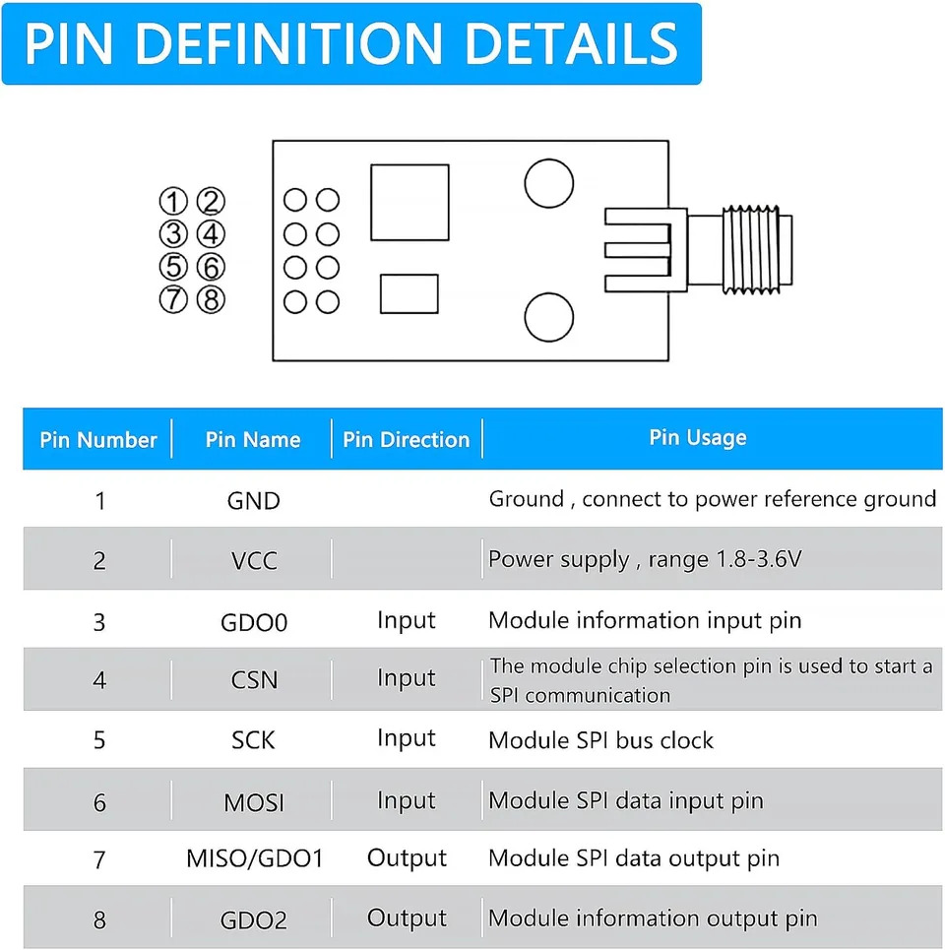
scs-docs/cc1101-pinout.jpg
