ElPudgino/LOS/scs-docs/level-shifter.webp

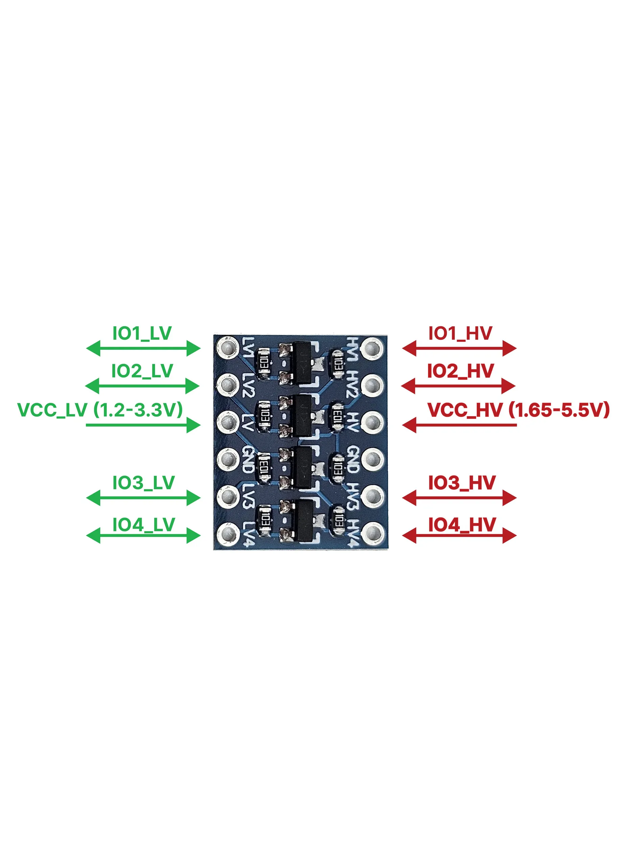
scs-docs/level-shifter.webp
