ElPudgino/LOS/scs-docs/mg995_drawing.jpg

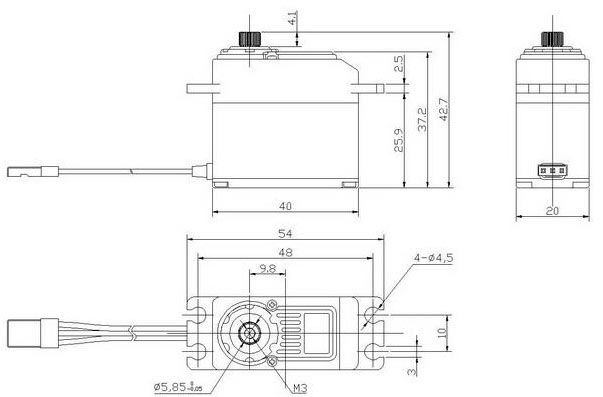
scs-docs/mg995_drawing.jpg
