ElPudgino/LOS/scs-project-docs/images/002.jpg

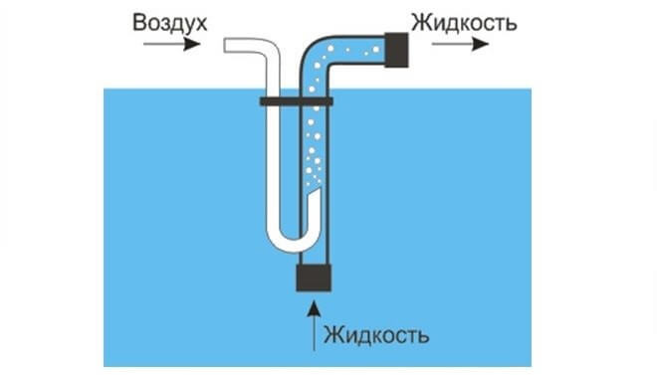
scs-project-docs/images/002.jpg
