ElPudgino/LOS/scs-project-docs/images/6eca100da55264ea44659f19fd9f6efb.jpg

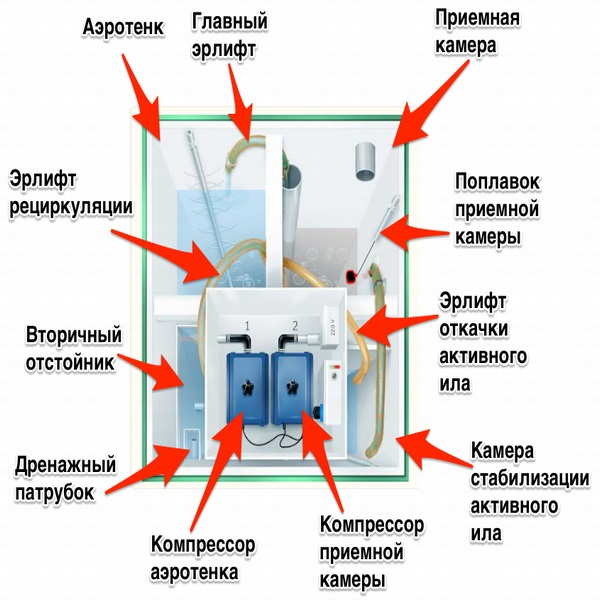
scs-project-docs/images/6eca100da55264ea44659f19fd9f6efb.jpg
