ElPudgino/LOS/scs-project-docs/images/Airlift.png

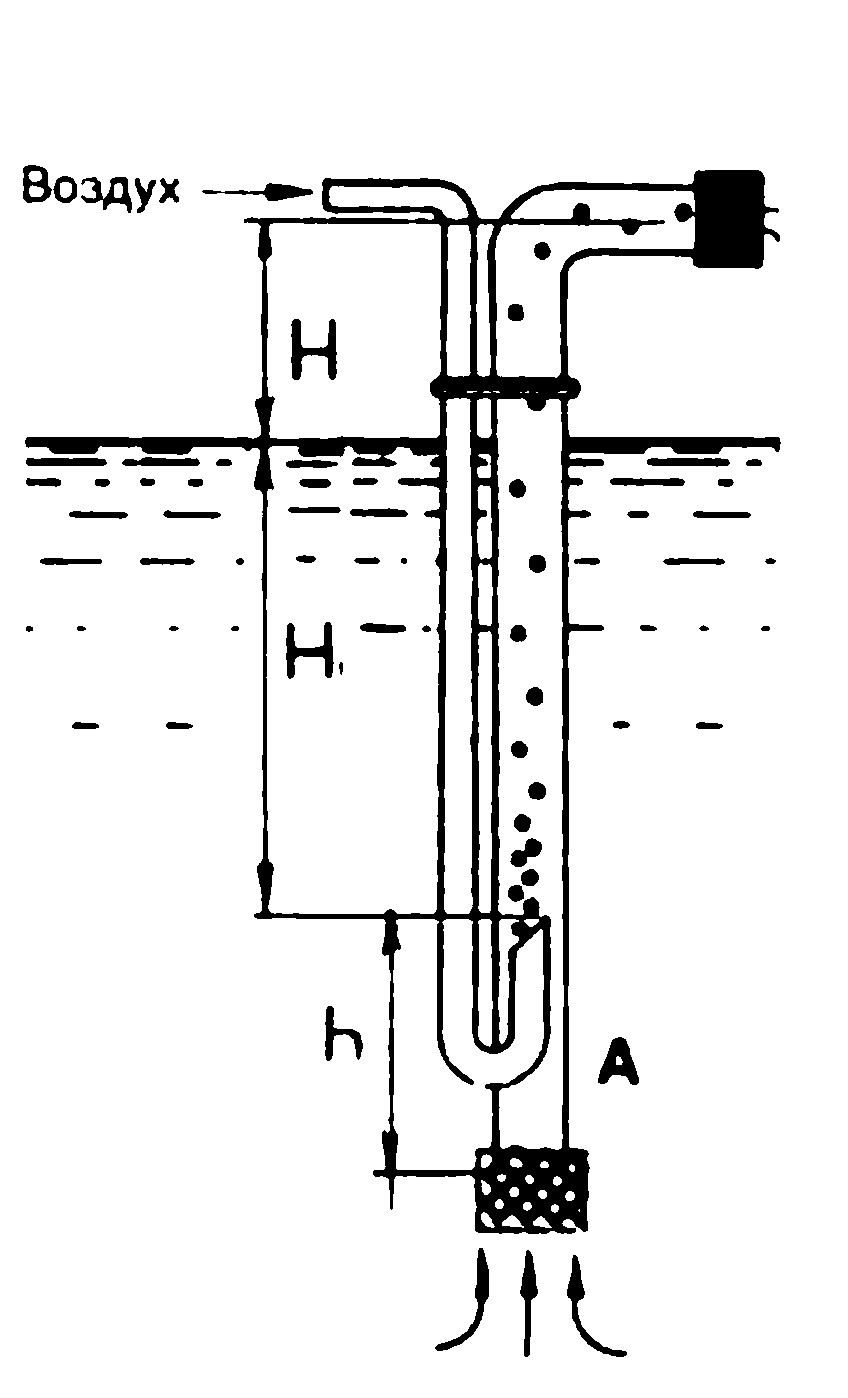
scs-project-docs/images/Airlift.png
