ElPudgino/LOS/scs-project-docs/images/statshema.png

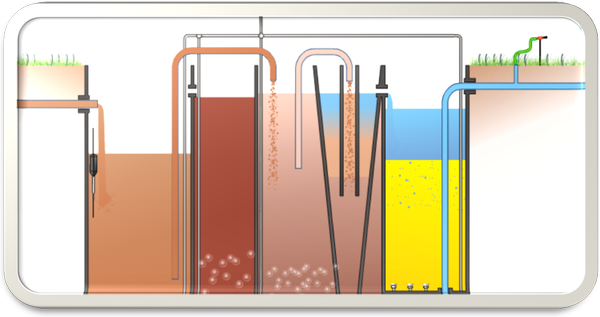
scs-project-docs/images/statshema.png
