ElPudgino/LOS/scs-project-docs/images/TLf9nCX5ft4.jpg

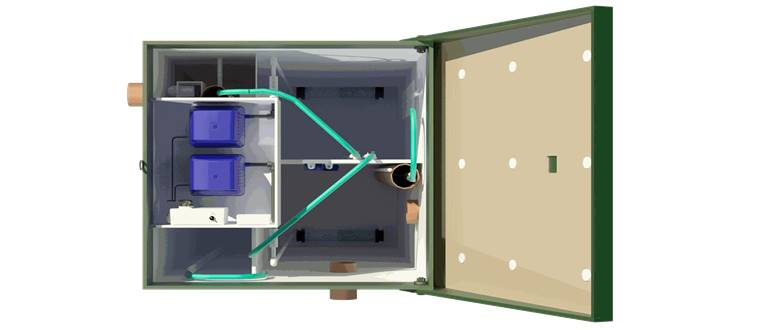
scs-project-docs/images/TLf9nCX5ft4.jpg
