ElPudgino/LOS/scs-project-docs/images/W3vWarteI9M.jpg

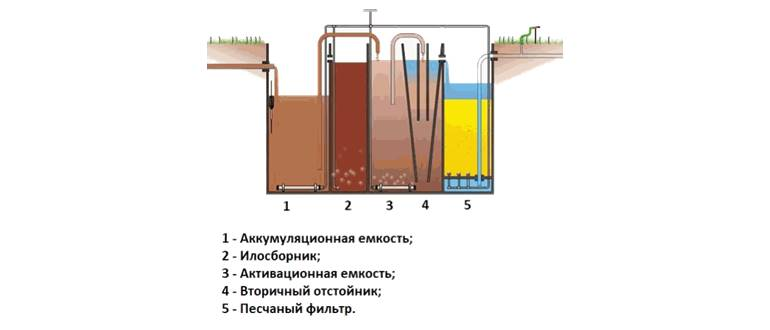
scs-project-docs/images/W3vWarteI9M.jpg
