ElPudgino/LOS/scs-receiver-pcb-v1/scs-receiver-pcb-v1.png

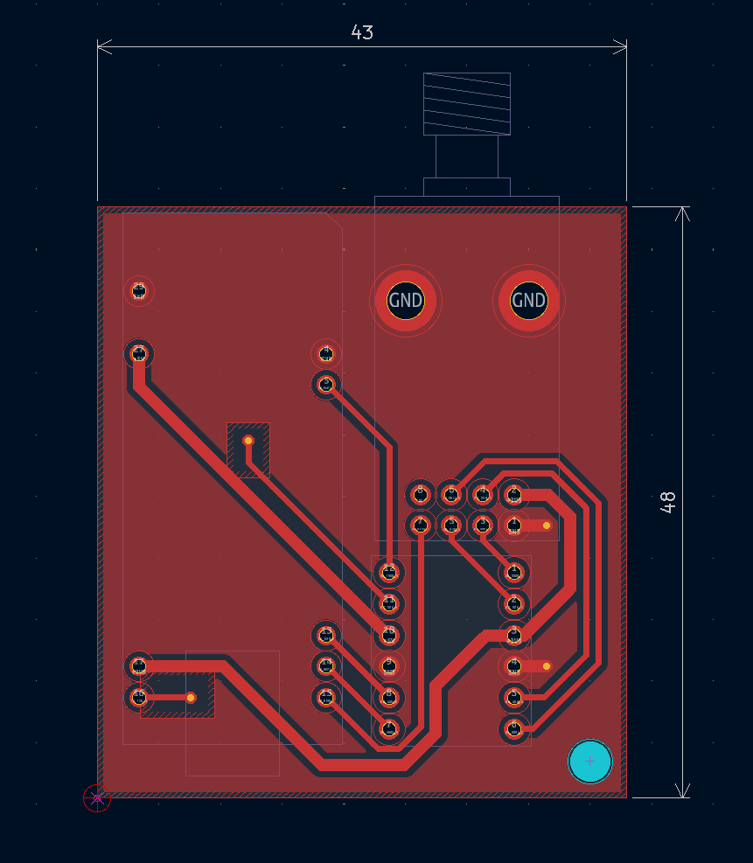
scs-receiver-pcb-v1/scs-receiver-pcb-v1.png
