ElPudgino/LOS/scs-stand-ps/photo/photo-1.jpg

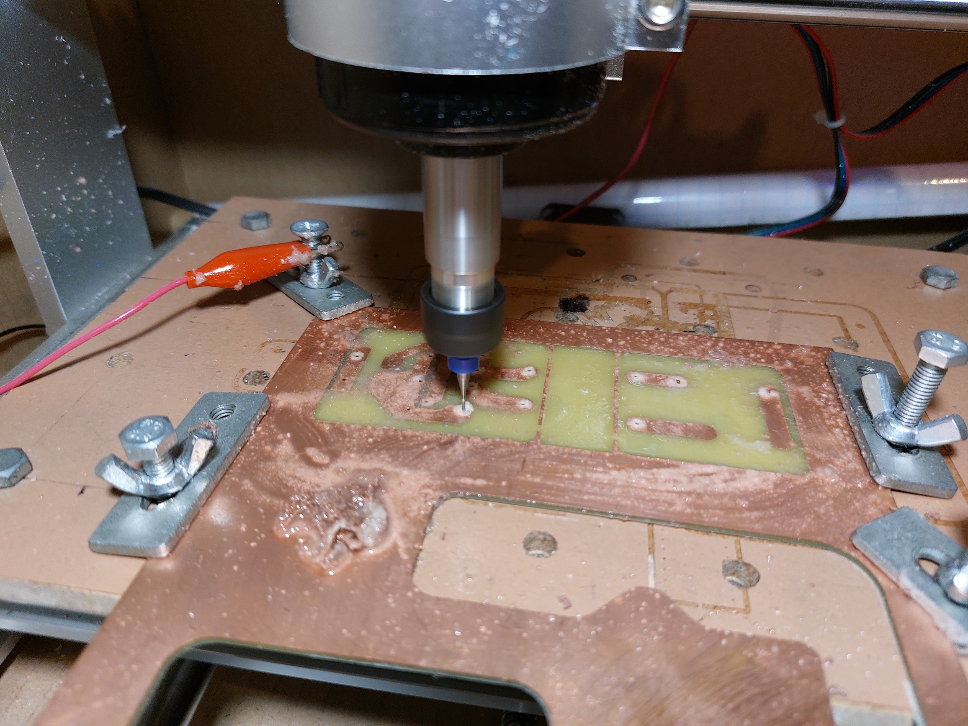
scs-stand-ps/photo/photo-1.jpg
