ElPudgino/LOS/scs-stand-ps/photo/photo-2.jpg

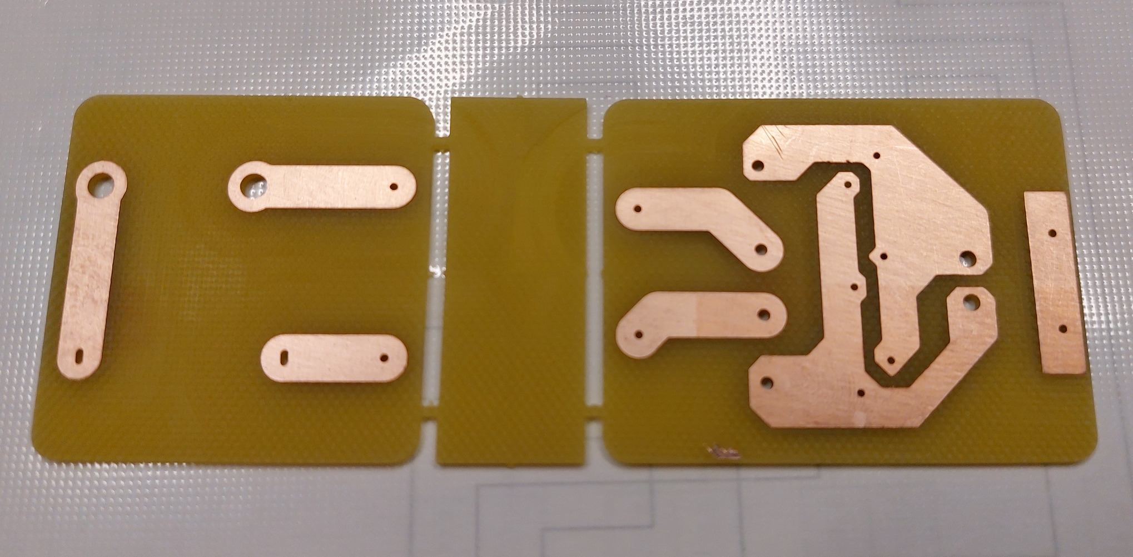
scs-stand-ps/photo/photo-2.jpg
