ElPudgino/LOS/scs-stand-ps/photo/photo-3.jpg

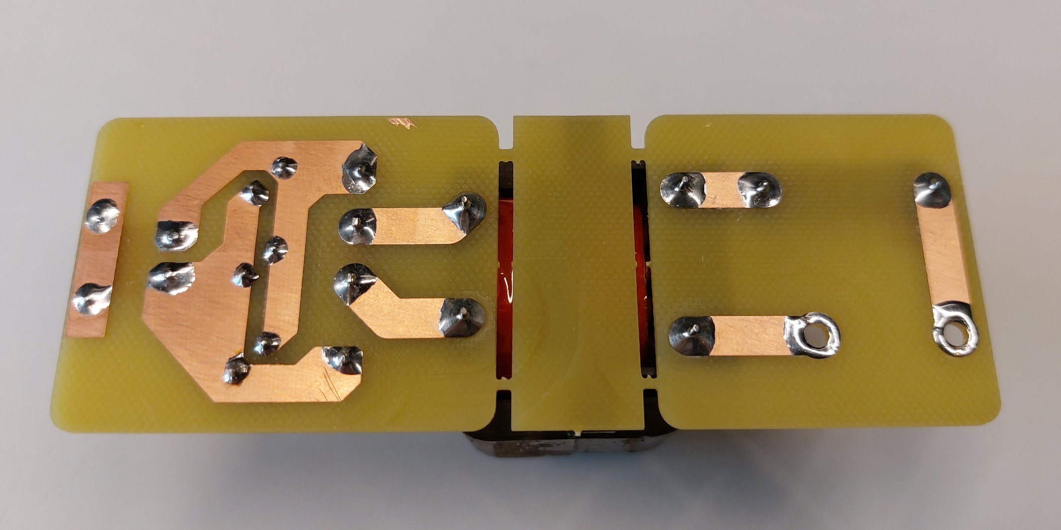
scs-stand-ps/photo/photo-3.jpg
