ElPudgino/LOS/scs-stand-ps/photo/photo-4.jpg

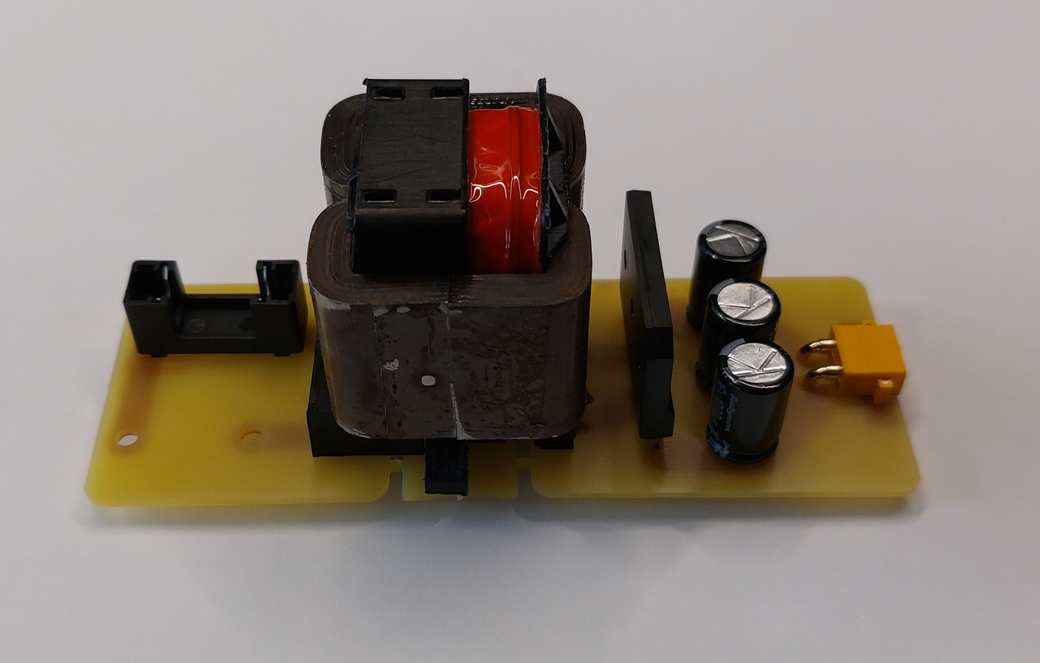
scs-stand-ps/photo/photo-4.jpg
