ElPudgino/LOS/scs-stand-ps/photo/photo-5.jpg

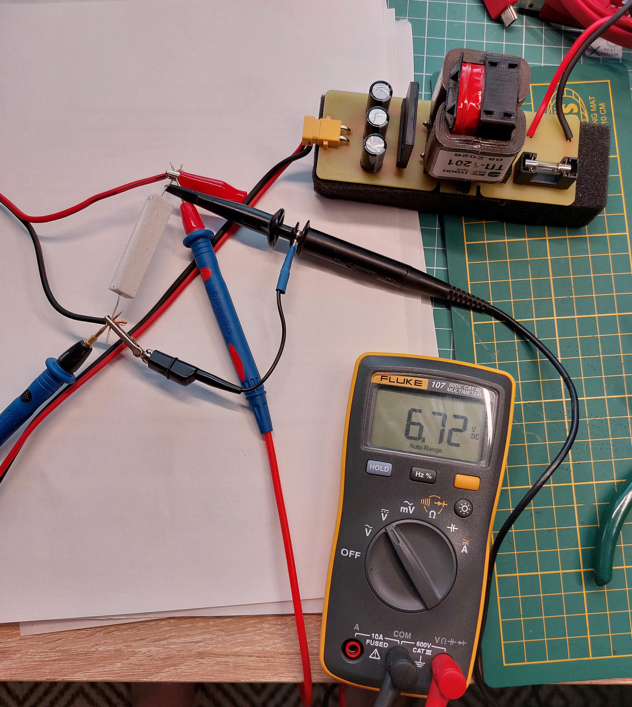
scs-stand-ps/photo/photo-5.jpg
