ElPudgino/LOS/scs-stand-ps/photo/photo-6.jpg

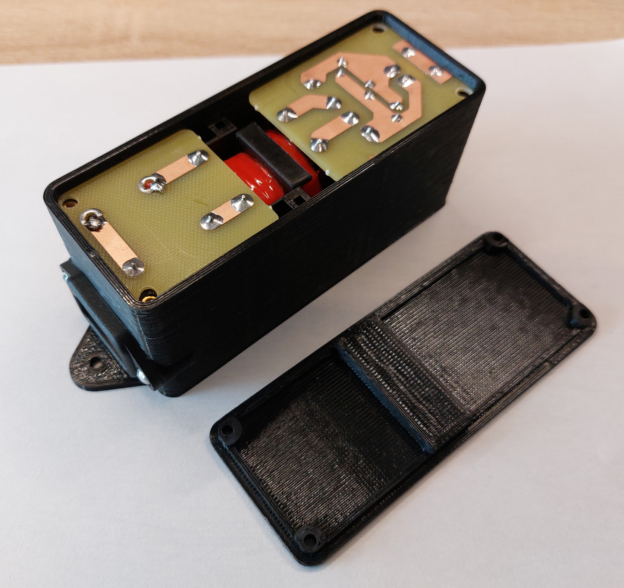
scs-stand-ps/photo/photo-6.jpg
