ElPudgino/LOS/scs-transmitter-pcb-v1/scs-transmiter-pcb-v1.png

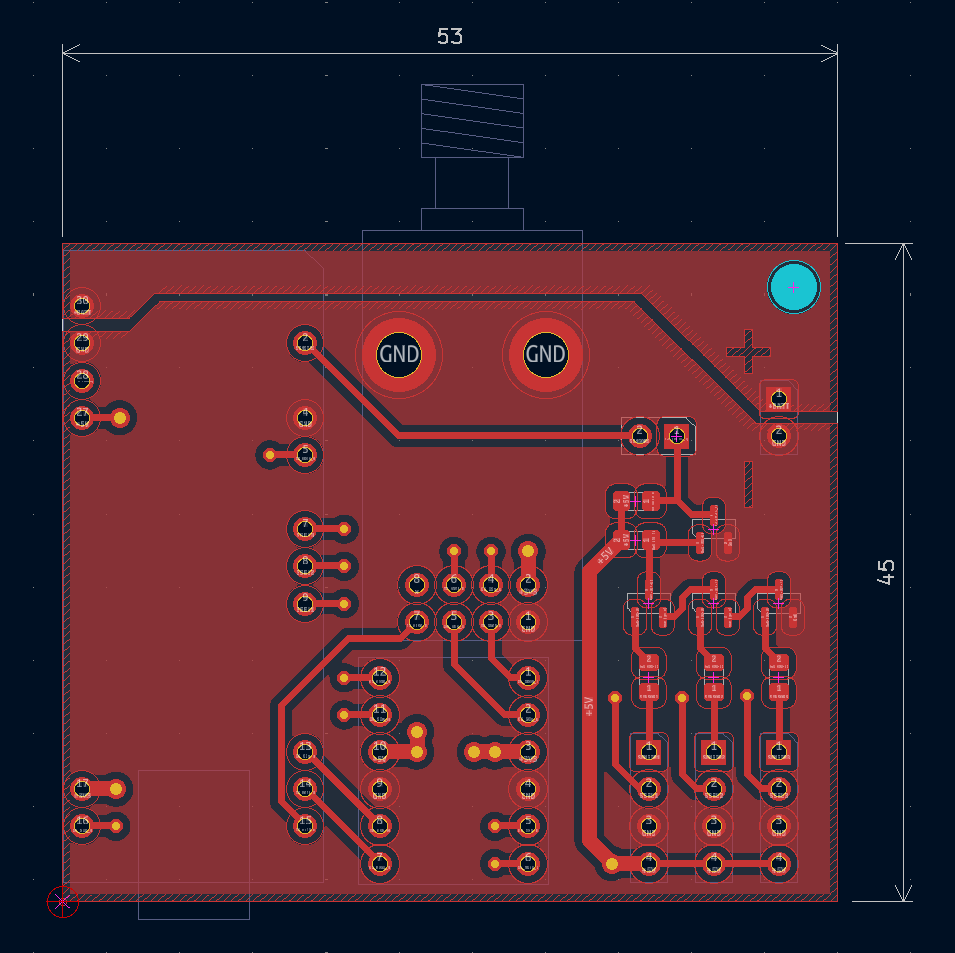
scs-transmitter-pcb-v1/scs-transmiter-pcb-v1.png
