ElPudgino/LOS/scs-water-sensor-ch32v003/water-sensor-ch32v003.png

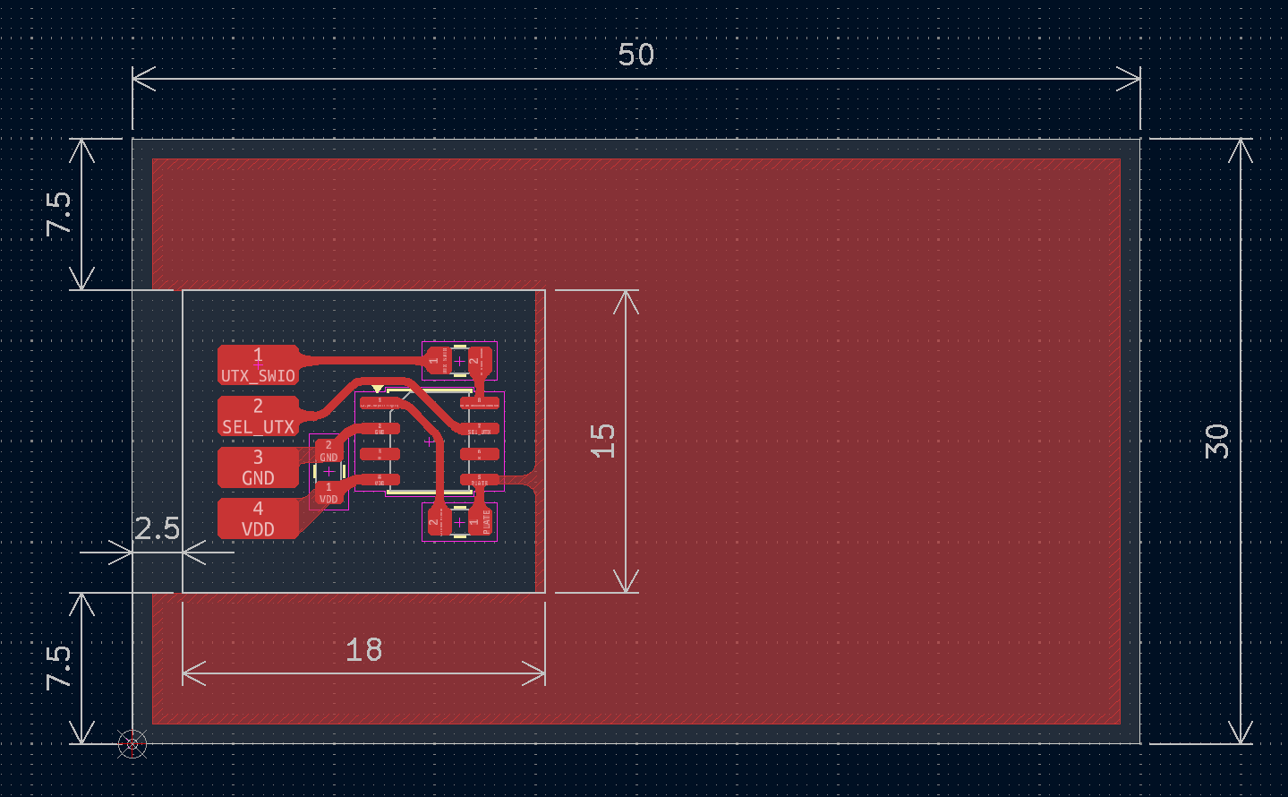
scs-water-sensor-ch32v003/water-sensor-ch32v003.png
