ElPudgino/LOS/scs-3d-models/src/floater-holder.FCStd

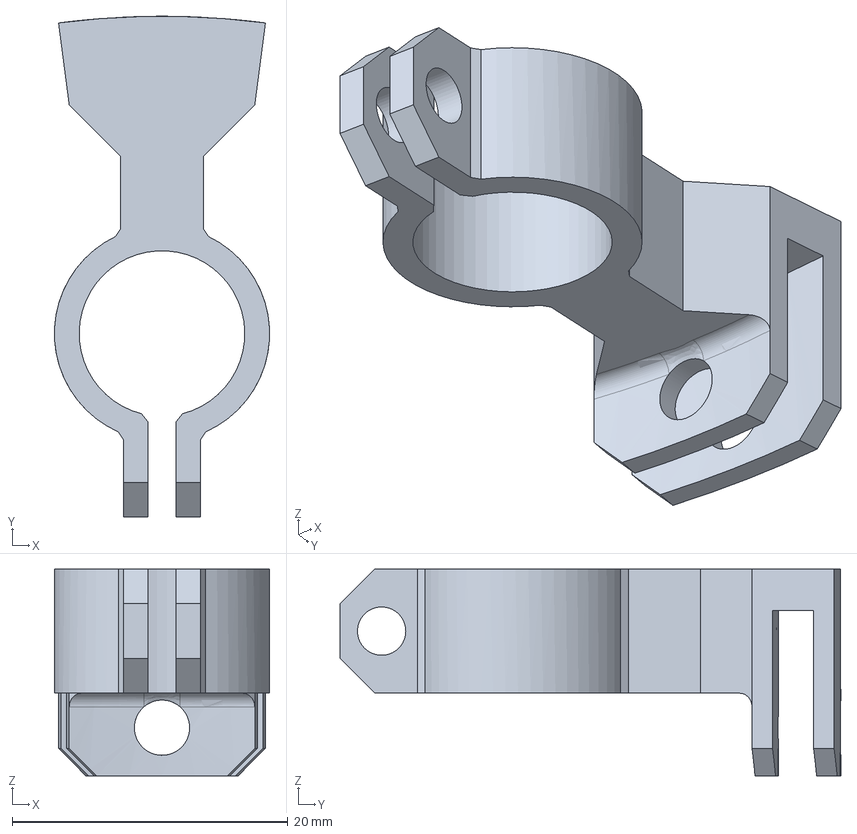
[picture p30: CAD file, 2026-11-09]
scs-3d-models/src/floater-holder.FCStd
15.6 x 36.3 x 15.0 mm
