ElPudgino/LOS/scs-3d-models/stl/air-valve-base-p1.stl

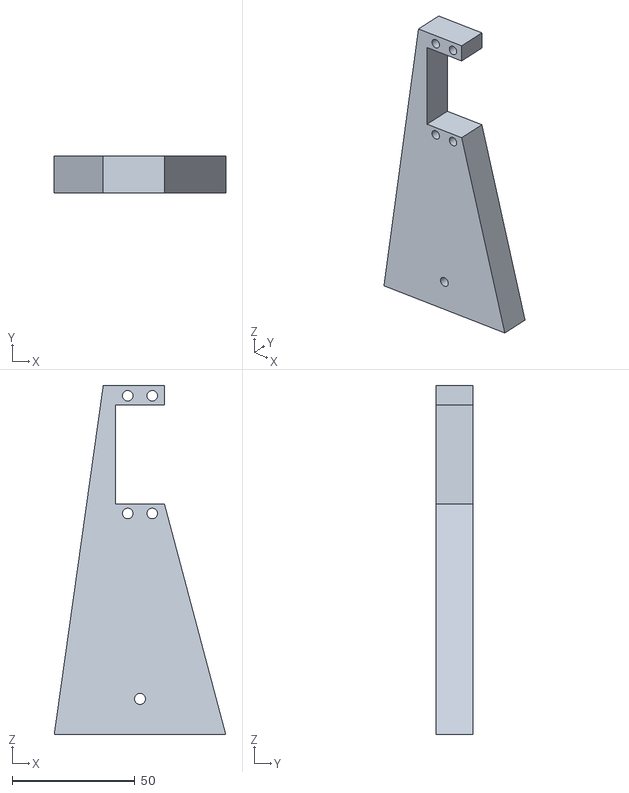
[picture p31: CAD file, 2026-11-09]
scs-3d-models/stl/air-valve-base-p1.stl
70.0 x 15.0 x 142.4
