ElPudgino/LOS/scs-stand-ps/stand-ps.step

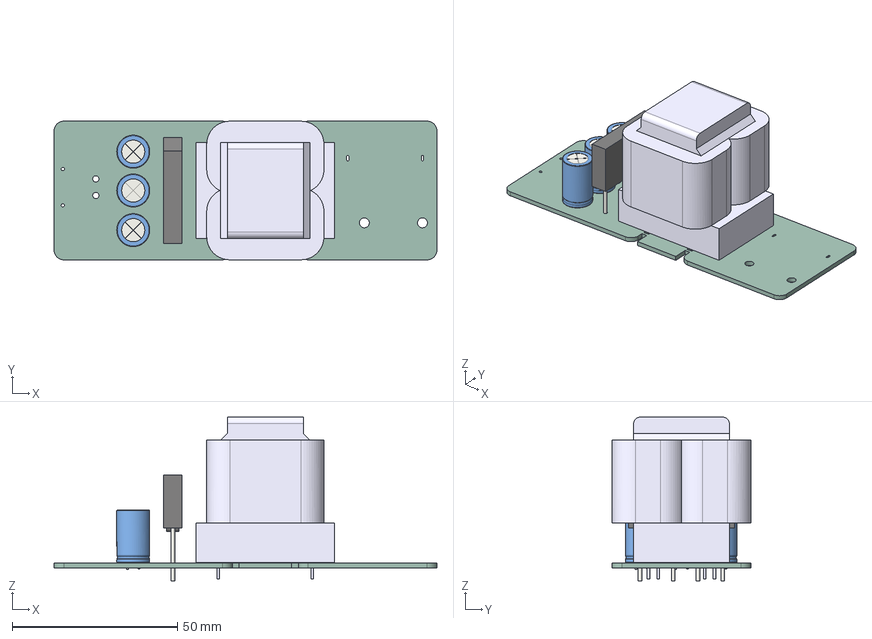
[picture p32: CAD file, 2026-11-09]
scs-stand-ps/stand-ps.step
116.0 x 42.0 x 49.6 mm
C_Radial_D100mm_H160mm_P500mm x 3
Diode_Bridge_32.0x5.6x17.0mm_P10.0mm_P7.5mm
stand-ps-unsaved-export-9fz59c_PCB
