ElPudgino/LOS/scs-3d-models/src/servo-rocker.FCStd

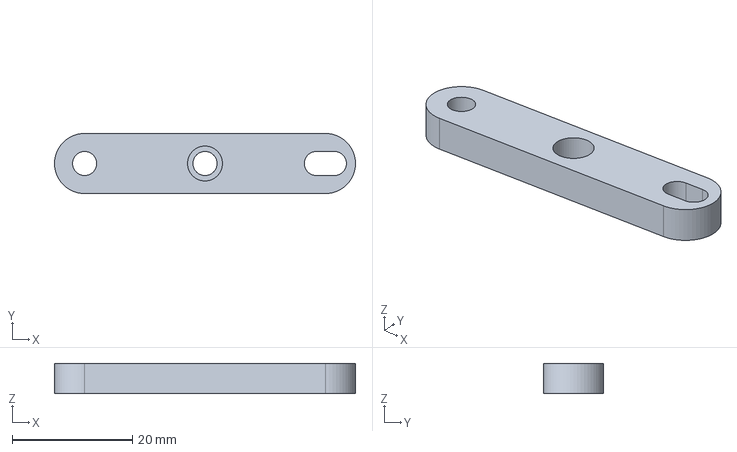
[picture p33: CAD file, 2026-11-09]
scs-3d-models/src/servo-rocker.FCStd
50.0 x 10.0 x 5.00 mm
