ElPudgino/LOS/scs-3d-models/stl/pipe-top-holder.stl

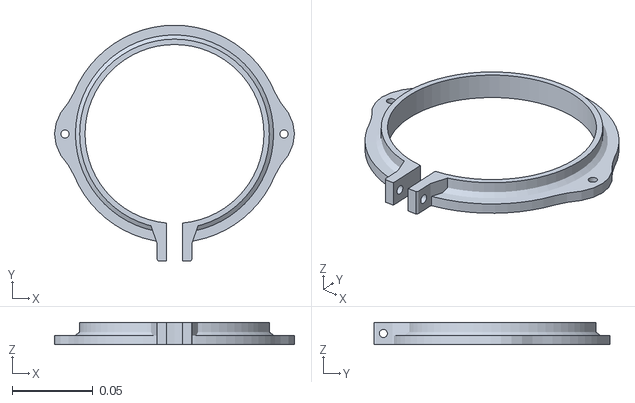
[picture p34: CAD file, 2026-11-09]
scs-3d-models/stl/pipe-top-holder.stl
0.149 x 0.146 x 0.0138
