ElPudgino/LOS/scs-3d-models/src/air-valve.FCStd

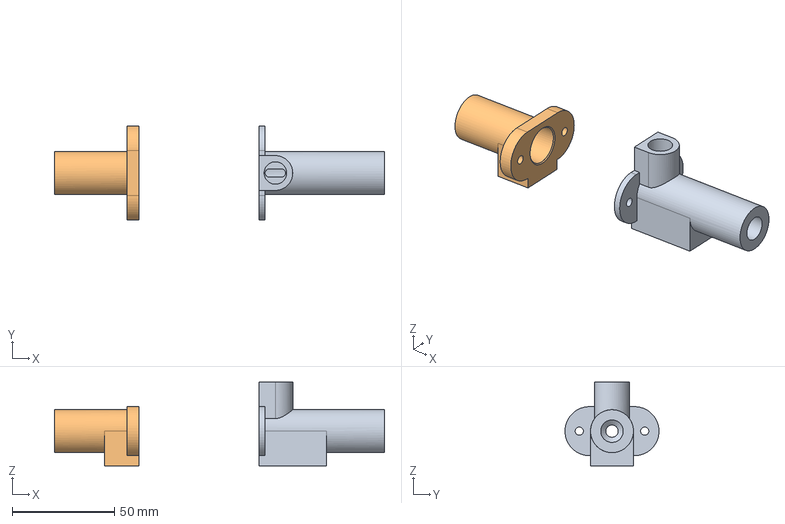
[picture p35: CAD file, 2026-11-09]
scs-3d-models/src/air-valve.FCStd
161.4 x 46.0 x 41.0 mm
