ElPudgino/LOS/scs-3d-models/stl/stand-ps-case-p1.stl

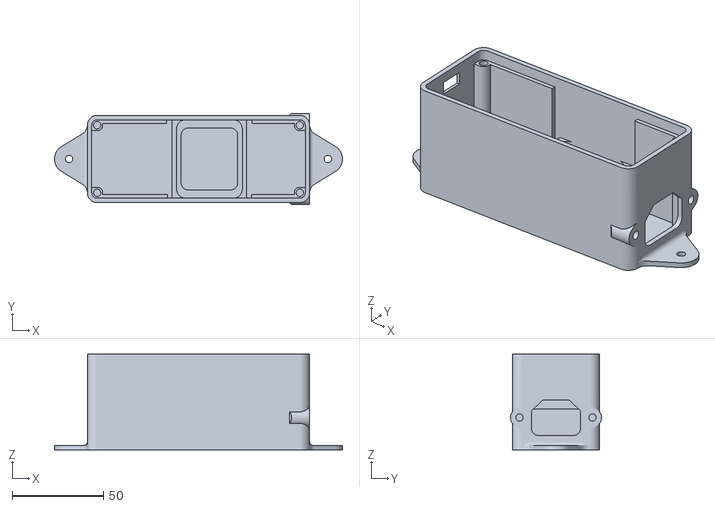
[picture p36: CAD file, 2026-11-09]
scs-3d-models/stl/stand-ps-case-p1.stl
157.8 x 50.0 x 52.4
