ElPudgino/LOS/scs-3d-models/src/air-valve-v2.FCStd

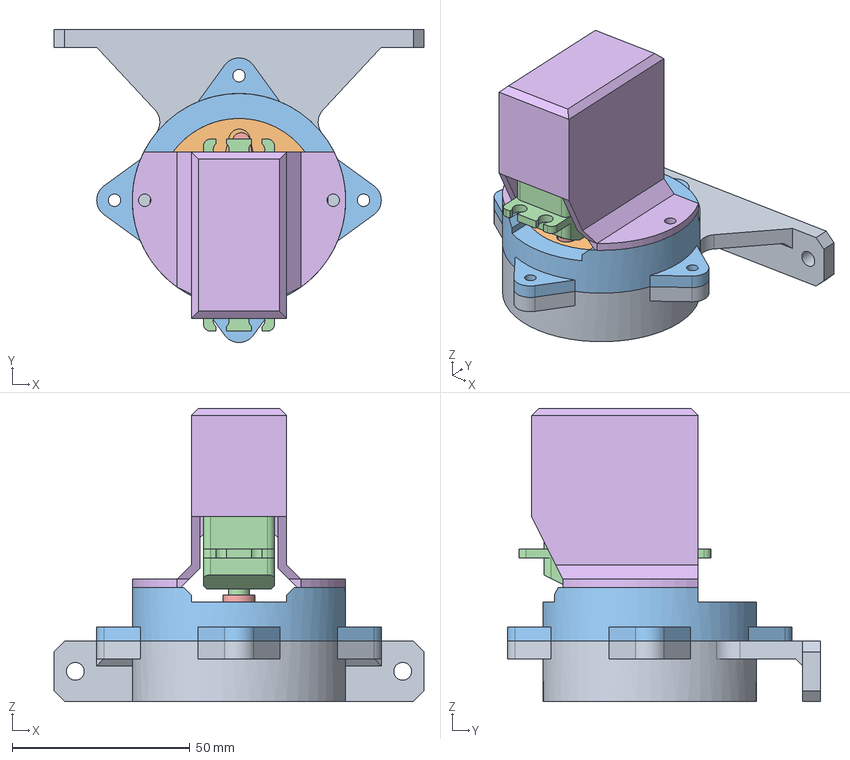
[picture p37: CAD file, 2026-11-09]
scs-3d-models/src/air-valve-v2.FCStd
104.0 x 88.0 x 82.4 mm
p1
p2
p3
servo
rocker
servo-hat
rod
