ElPudgino/LOS/scs-3d-models/stl/airlift-holder.stl

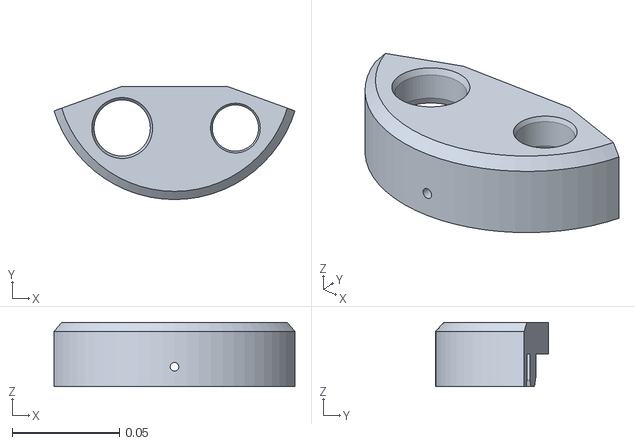
[picture p38: CAD file, 2026-11-09]
scs-3d-models/stl/airlift-holder.stl
0.113 x 0.0528 x 0.03
