ElPudgino/LOS/scs-3d-models/src/stand-ps-case.FCStd

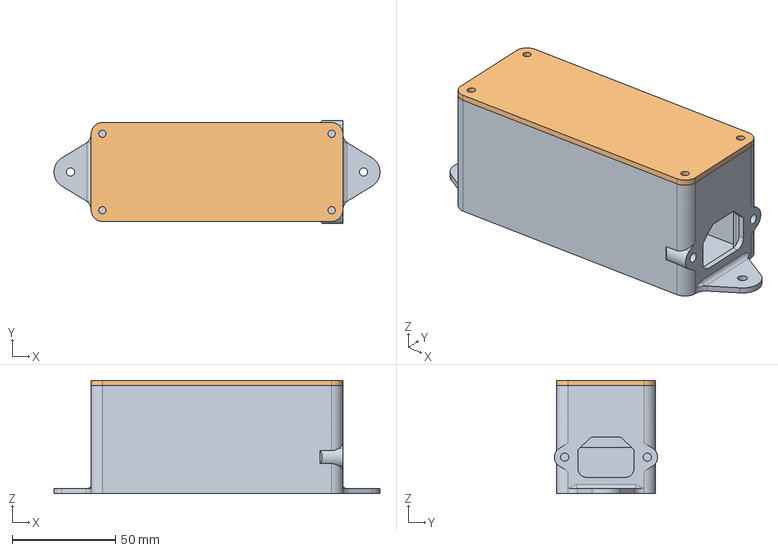
[picture p39: CAD file, 2026-11-09]
scs-3d-models/src/stand-ps-case.FCStd
157.8 x 50.0 x 54.8 mm
