ElPudgino/LOS/scs-3d-models/stl/pipe-bottom-holder-2.stl

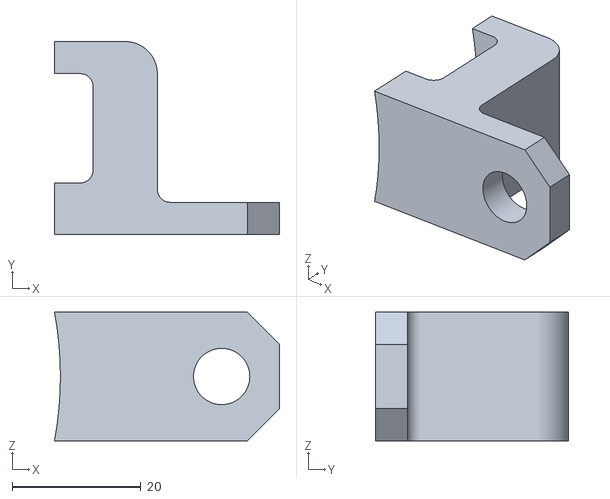
[picture p40: CAD file, 2026-11-09]
scs-3d-models/stl/pipe-bottom-holder-2.stl
35.0 x 30.0 x 20.0
