ElPudgino/LOS/scs-3d-models/stl/pipe-bottom-holder.stl

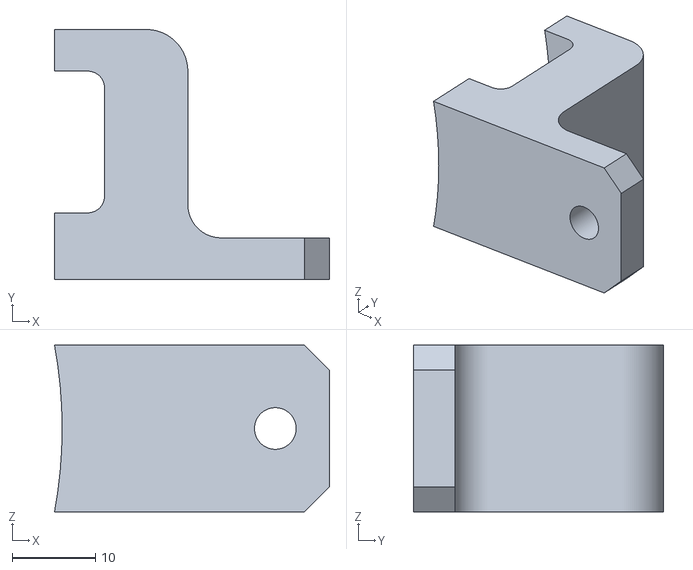
[picture p41: CAD file, 2026-11-09]
scs-3d-models/stl/pipe-bottom-holder.stl
33.0 x 30.0 x 20.0
