ElPudgino/LOS/scs-3d-models/stl/air-valve-v2-p3.stl

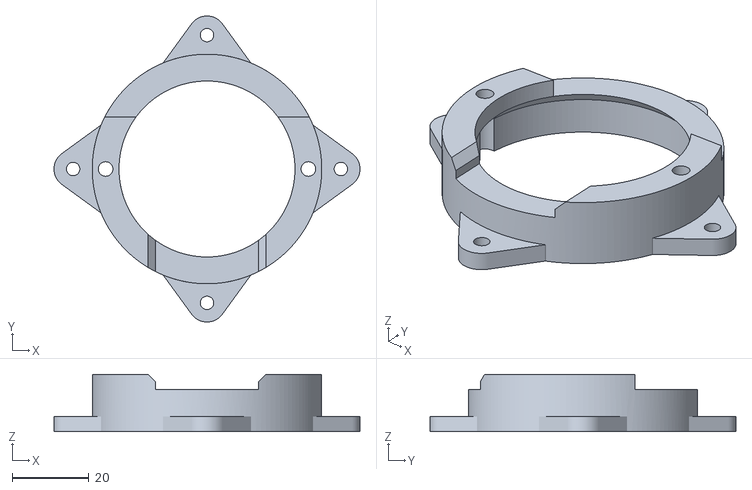
[picture p42: CAD file, 2026-11-09]
scs-3d-models/stl/air-valve-v2-p3.stl
80.0 x 80.0 x 15.0
