ElPudgino/LOS/scs-3d-models/stl/sensor-ch32-case.stl

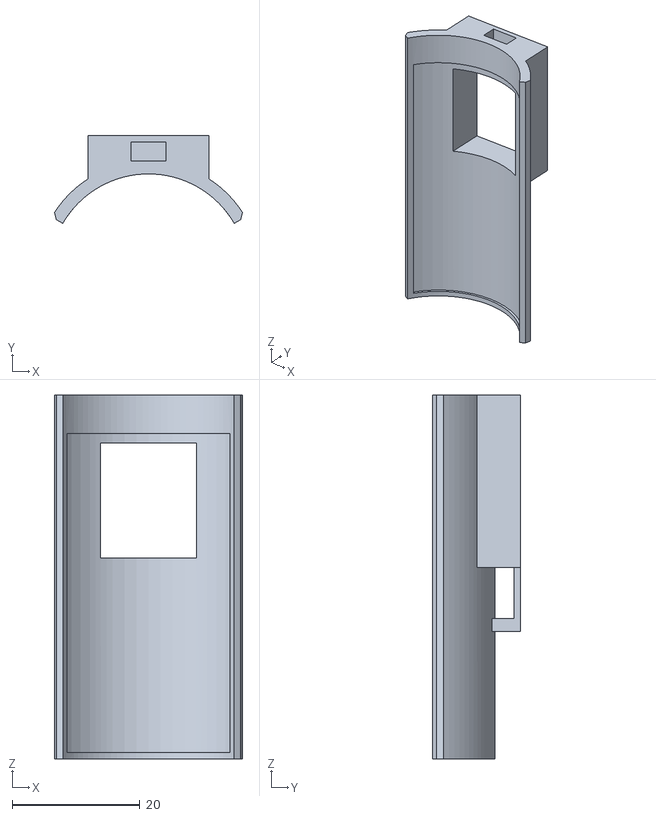
[picture p43: CAD file, 2026-11-09]
scs-3d-models/stl/sensor-ch32-case.stl
29.5 x 13.8 x 57.0
