ElPudgino/LOS/scs-3d-models/stl/sensor-ch32.3mf

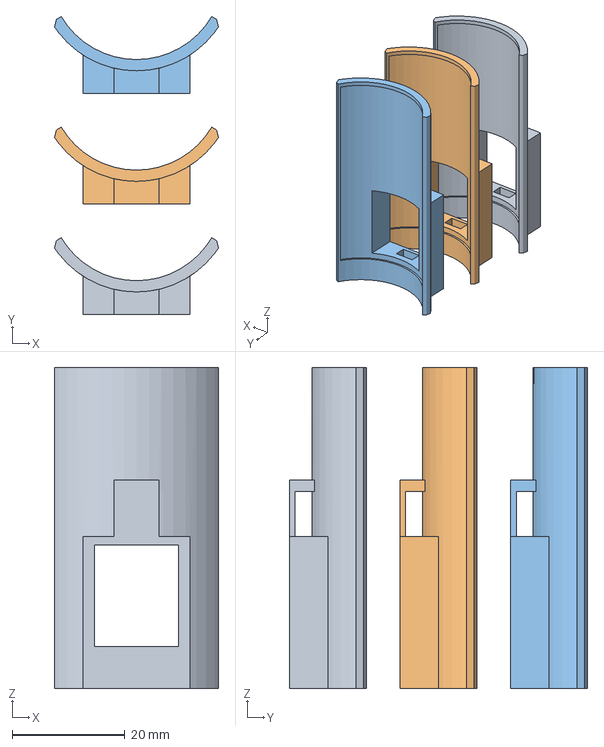
[picture p44: CAD file, 2026-11-09]
scs-3d-models/stl/sensor-ch32.3mf
29.1 x 52.9 x 57.0 mm
