ElPudgino/LOS/scs-3d-models/stl/stand-ps-case-p2.stl

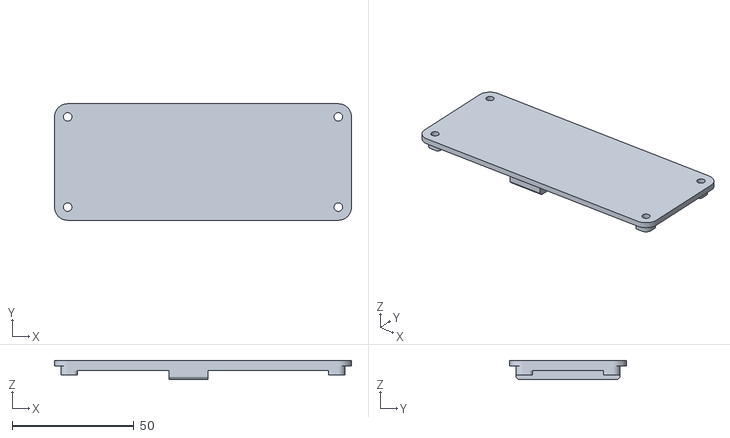
[picture p45: CAD file, 2026-11-09]
scs-3d-models/stl/stand-ps-case-p2.stl
121.8 x 47.8 x 7.90
