ElPudgino/LOS/scs-3d-models/stl/air-valve-v2-servo-hat.stl

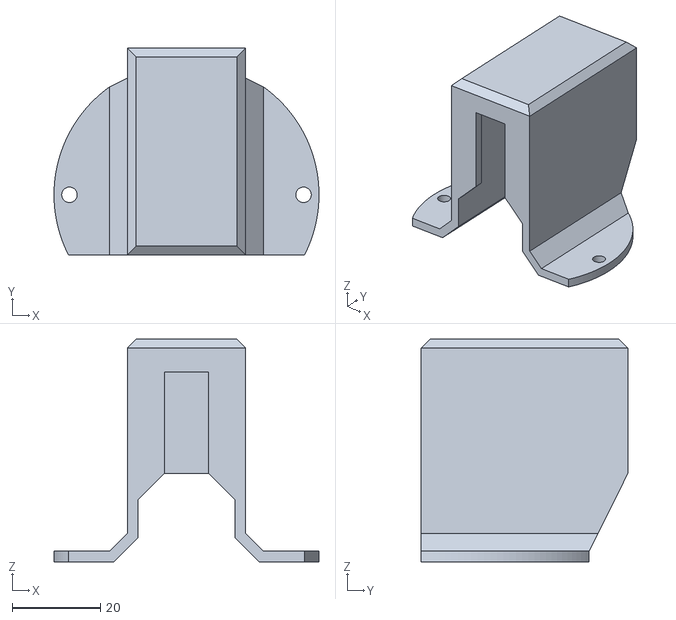
[picture p46: CAD file, 2026-11-09]
scs-3d-models/stl/air-valve-v2-servo-hat.stl
60.0 x 46.8 x 50.4
