ElPudgino/LOS/scs-3d-models/stl/air-valve-v2-rod.stl

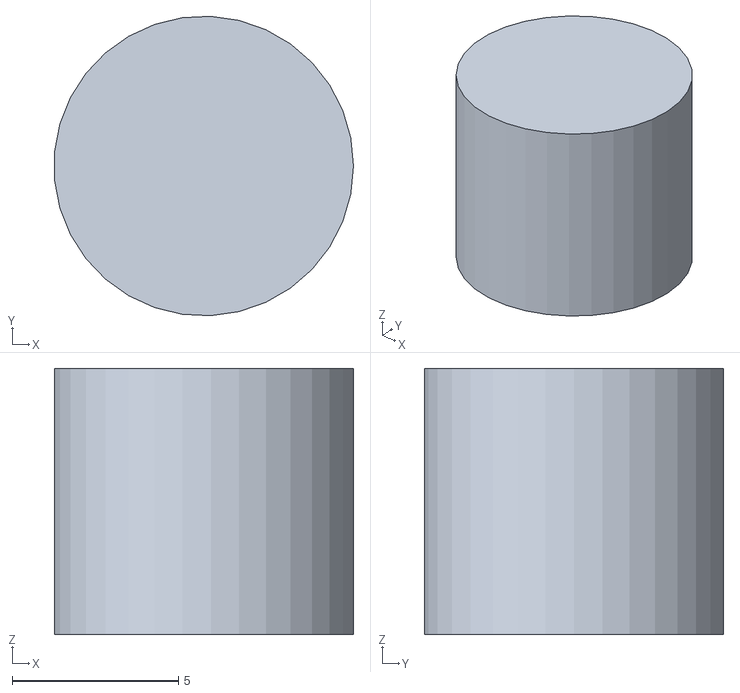
[picture p47: CAD file, 2026-11-09]
scs-3d-models/stl/air-valve-v2-rod.stl
8.98 x 8.99 x 8.00
