ElPudgino/LOS/scs-3d-models/stl/pring.stl

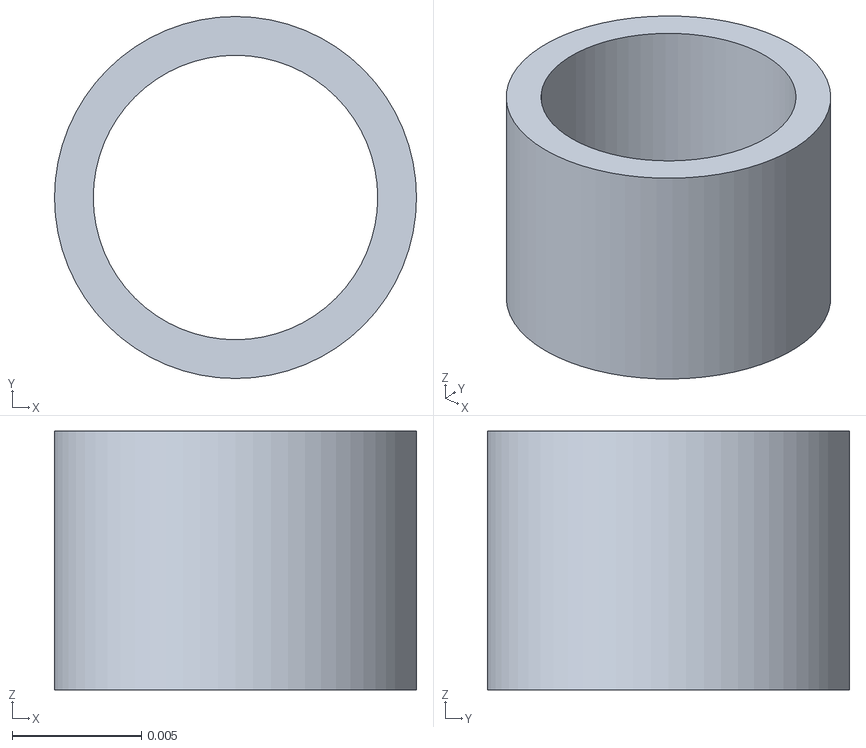
[picture p48: CAD file, 2026-11-09]
scs-3d-models/stl/pring.stl
0.014 x 0.014 x 0.01
