ElPudgino/LOS/scs-3d-models/stl/air-valve-base-p2.stl

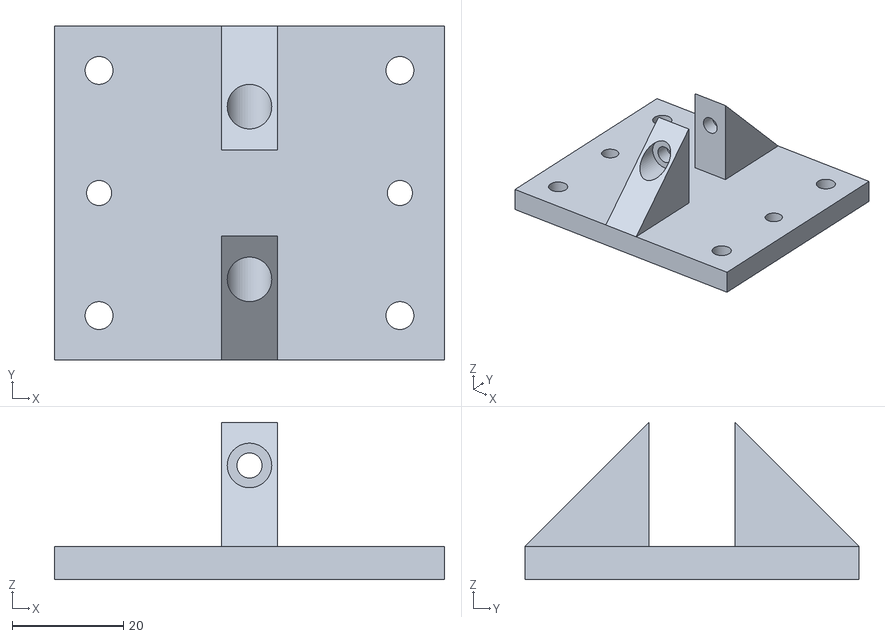
[picture p49: CAD file, 2026-11-09]
scs-3d-models/stl/air-valve-base-p2.stl
70.0 x 60.0 x 28.2
