ElPudgino/LOS/scs-3d-models/stl/air-valve-v2-p1.stl

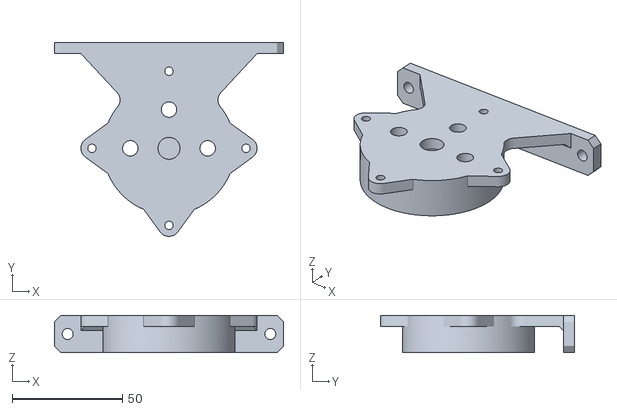
[picture p50: CAD file, 2026-11-09]
scs-3d-models/stl/air-valve-v2-p1.stl
104.0 x 88.0 x 17.0
