ElPudgino/LOS/scs-3d-models/stl/air-valve-v2-p2.stl

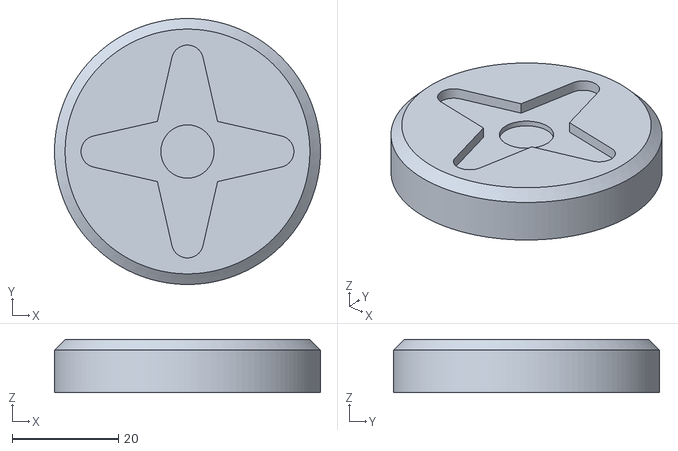
[picture p51: CAD file, 2026-11-09]
scs-3d-models/stl/air-valve-v2-p2.stl
50.0 x 50.0 x 10.0
