ElPudgino/LOS/(list of files, cad)

Other CAD files:
scs-3d-models/src/pipe-bottom-holder-2.FCStd
scs-3d-models/src/pipe-bottom-holder.FCStd
scs-3d-models/stl/floater-holder.stl
scs-3d-models/stl/servo-rocker.stl
scs-3d-models/src/pring.blend
scs-3d-models/stl/sensor-ch32.stl
