ElPudgino/LOS/scs-air-valve-pcb/air-valve-pcb.pdf

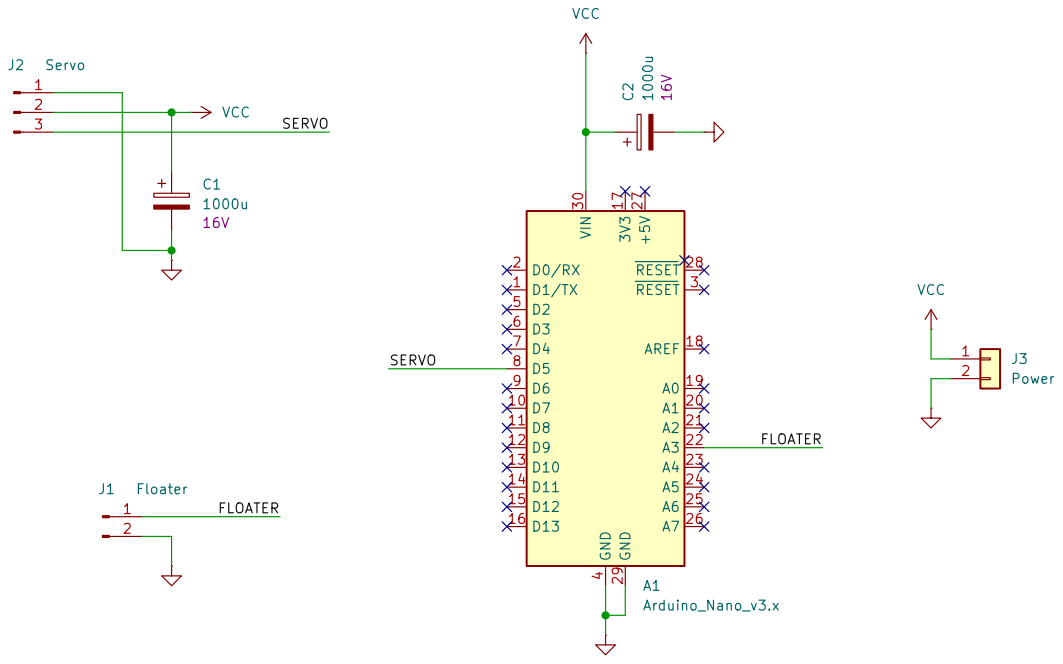
[picture p52: page 1]

Sheet: /
File: air-valve-pcb.kicad_sch
Title:

Size: A4 | Rev: | F Date:
KiCad E.D.A. 10.0.4 | Id: 1/1
