ElPudgino/LOS/scs-receiver-pcb-v1/scs-receiver-pcb-v1.pdf

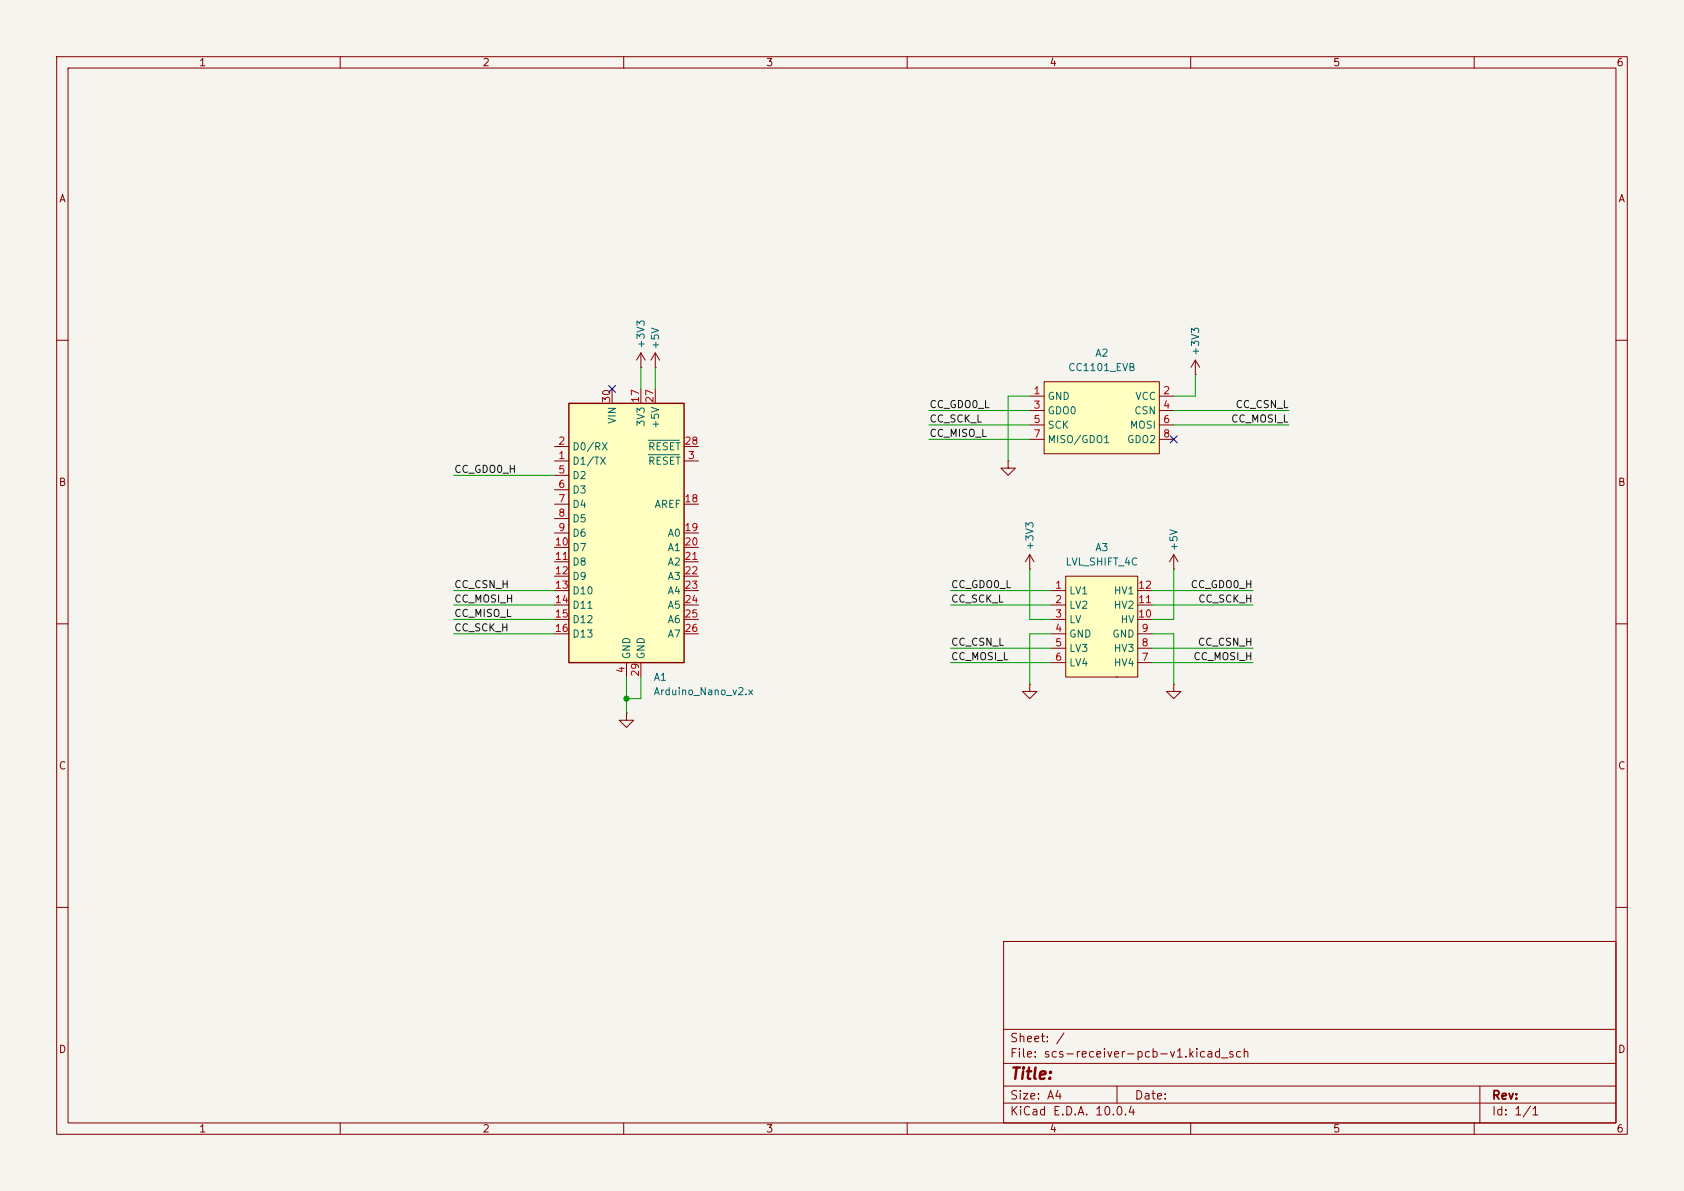
[picture p53: page 1]

File: scs-receiver-pcb-v1.kicad_sch
Title:

Size: A4 | Rev:
KiCad E.D.A. 10.0.4 | Id: 1/1
