ElPudgino/LOS/scs-stand-ps/stand-ps.pdf

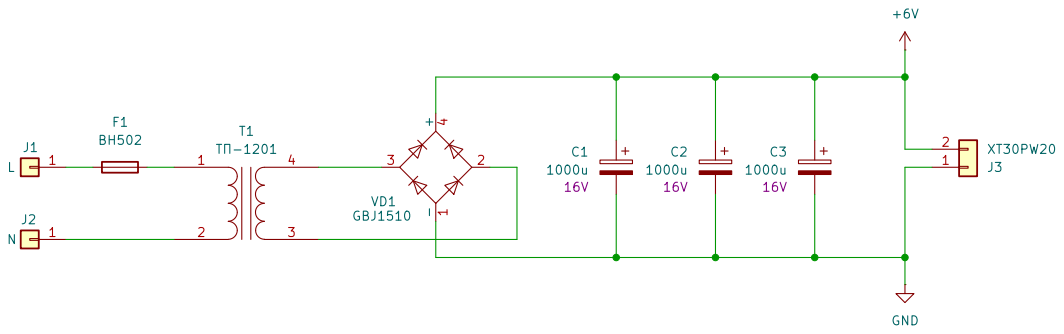
[picture p54: page 1]

Size: A4 | Rev: | F Date:
KiCad E.D.A. 10.0.4 | Id: 1/1
