ElPudgino/LOS/scs-water-sensor-ch32v003/water-sensor-ch32v003.pdf

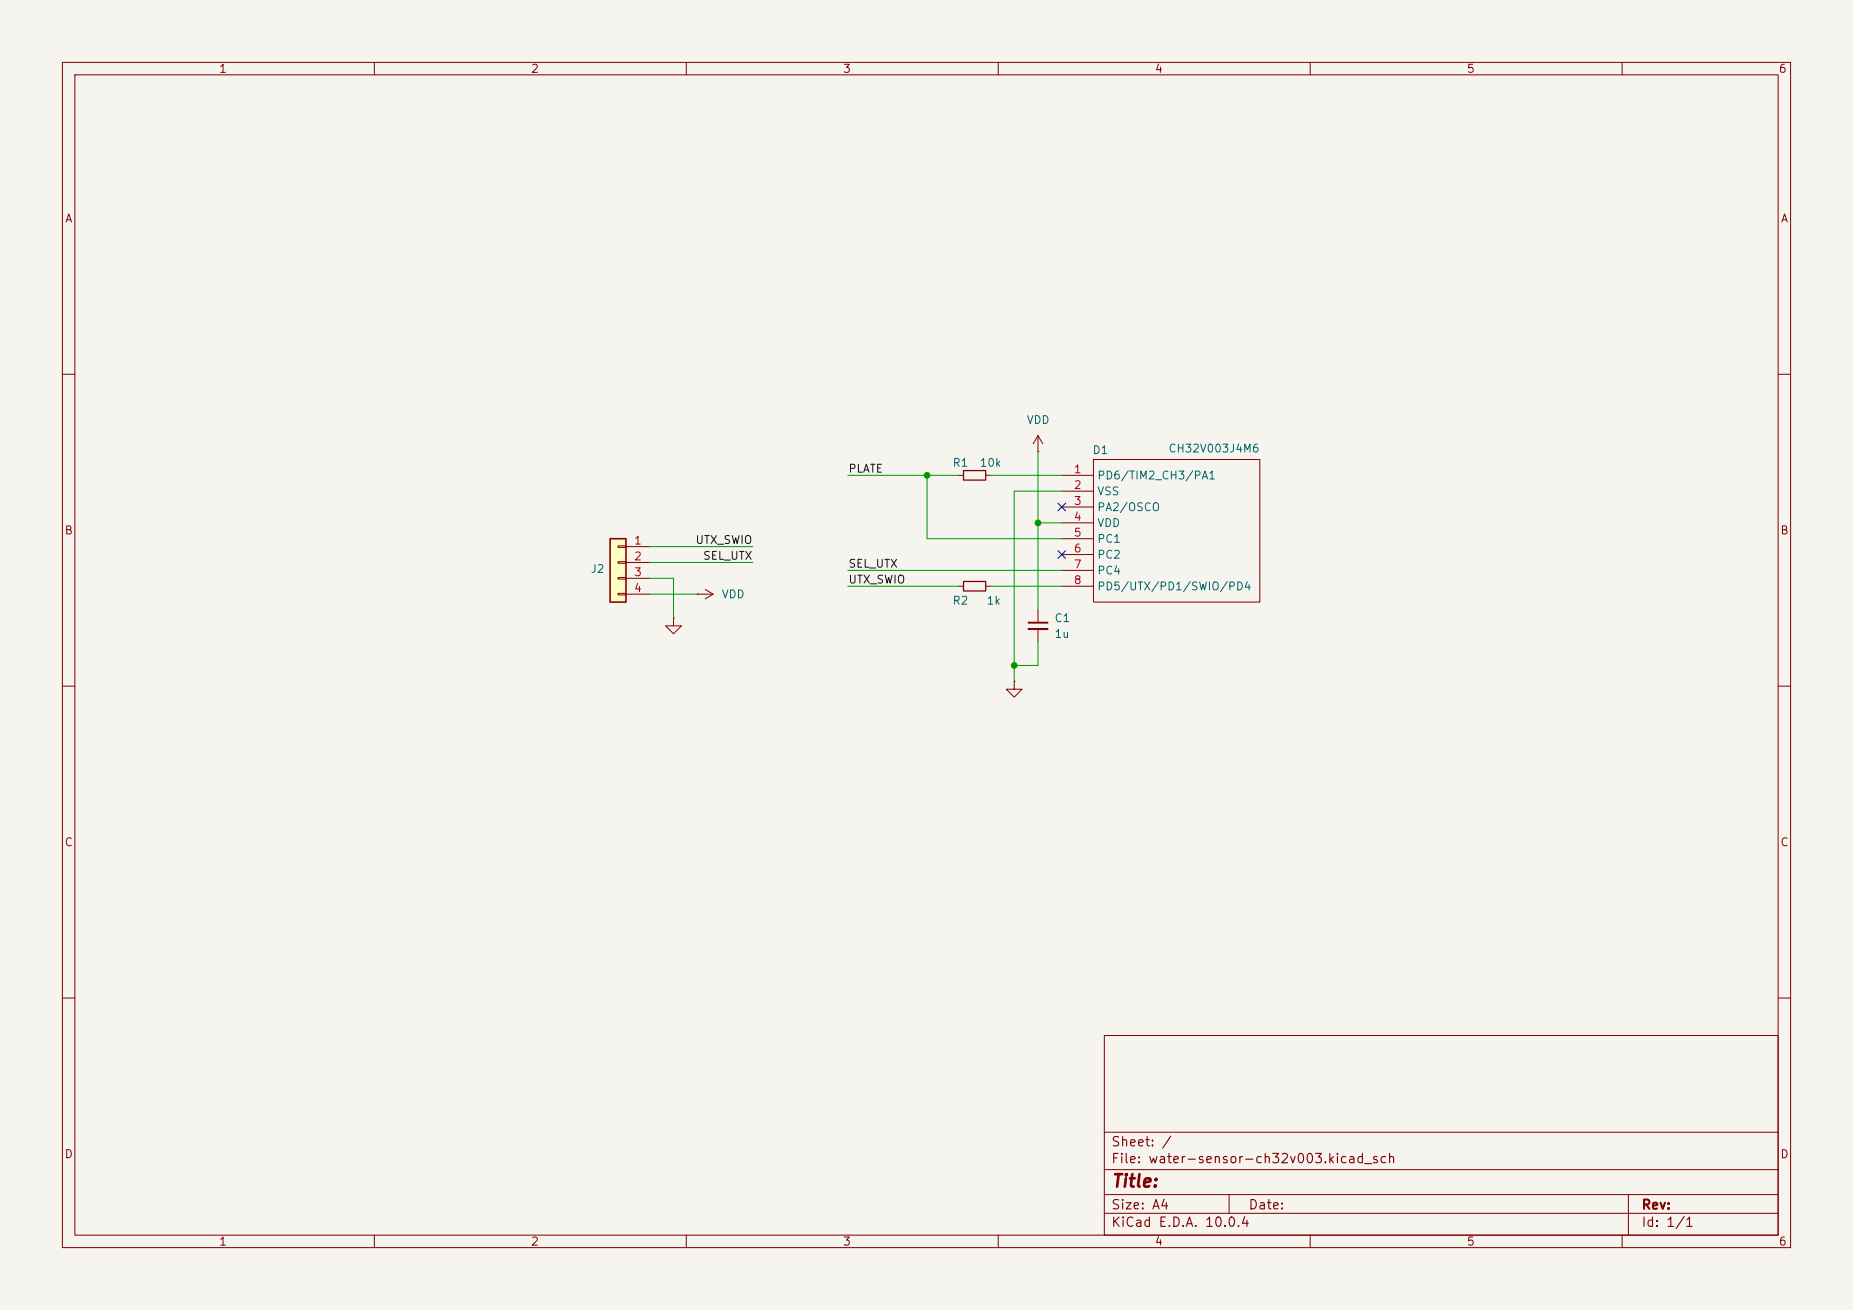
[picture p55: page 1]

Size: A4 | Rev:
KiCad E.D.A. 10.0.4 | Id: 1/1
