ElPudgino/LOS/scs-water-sensor-ch32v003/svg/water-sensor-ch32v003-F_Cu.pdf

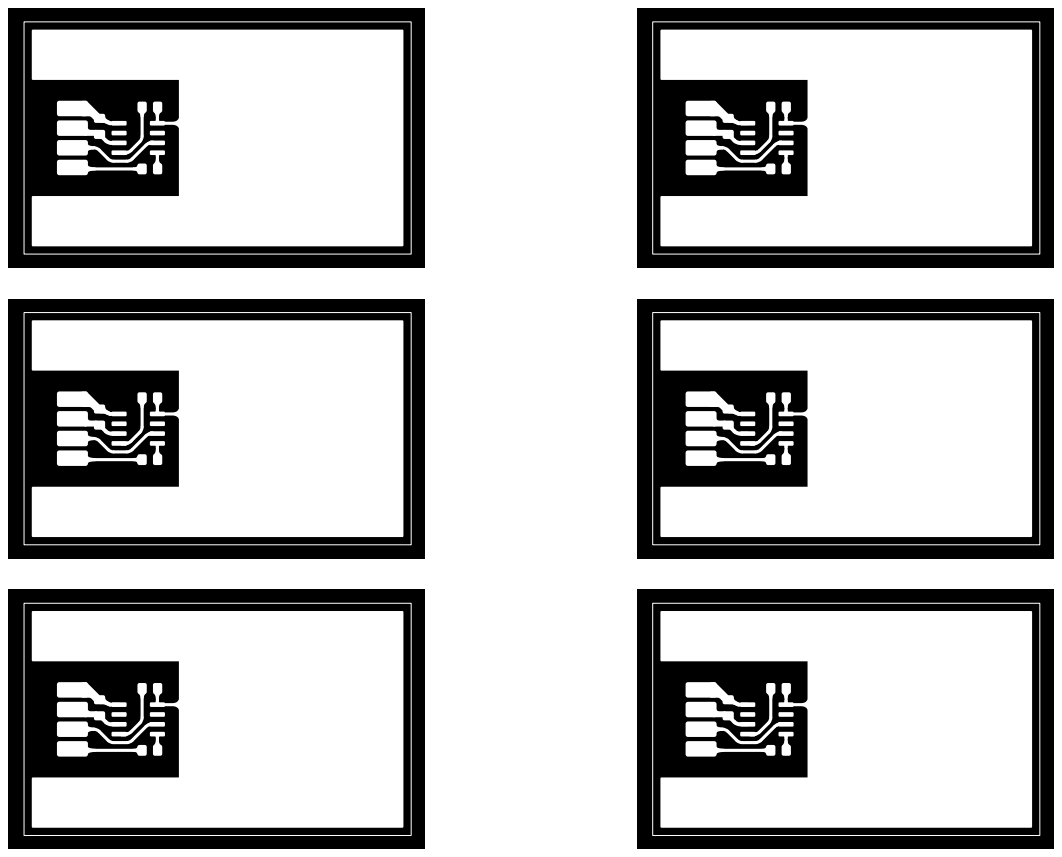
[picture p56: page 1]
