ElPudgino/LOS/scs-water-sensor-ch32v003/water-sensor-ch32v003.kicad_pcb

## KiCad design scs-water-sensor-ch32v003/water-sensor-ch32v003.kicad_pcb (2026-11-09)

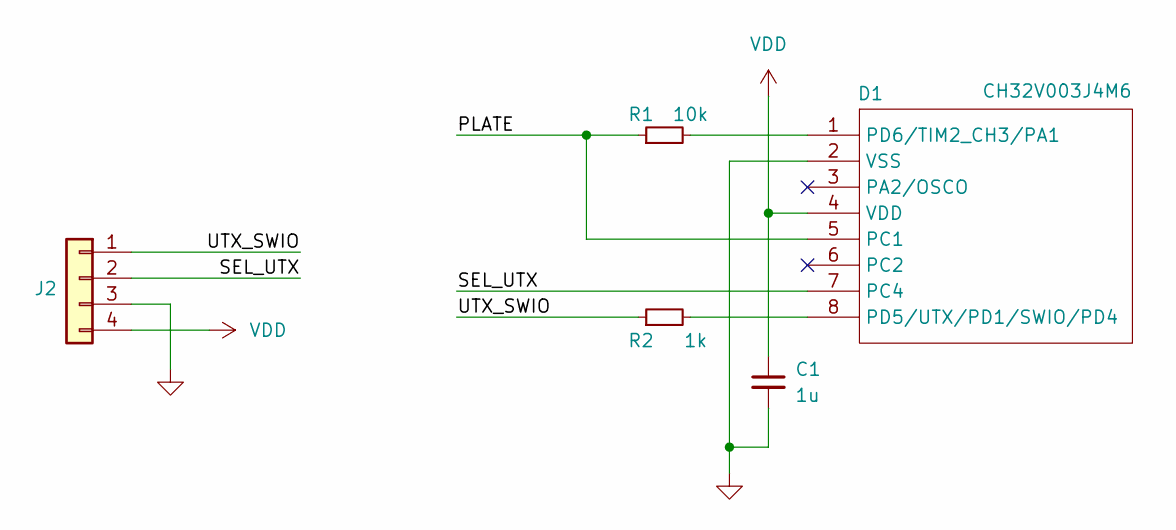
[picture p57: schematic water-sensor-ch32v003.kicad_sch]

Parts:
C1: 1u; C_0805_2012Metric_Pad1.18x1.45mm_HandSolder
D1: CH32V003J4M6; SOIC-8_3.9x4.9mm_P1.27mm
J2: Conn_01x04; CONN4
R1: 10k; R_0805_2012Metric_Pad1.20x1.40mm_HandSolder
R2: 1k; R_0805_2012Metric_Pad1.20x1.40mm_HandSolder

Connections:
/PLATE: D1.5 (PC1), R1.1
/SEL_UTX: D1.7 (PC4), J2.2
/UTX_SWIO: J2.1, R2.1
GND: C1.2, D1.2 (VSS), J2.3
unnamed: D1.8 (PD5/UTX/PD1/SWIO/PD4), R2.2
unnamed: D1.1 (PD6/TIM2_CH3/PA1), R1.2
VDD: C1.1, D1.4 (VDD), J2.4

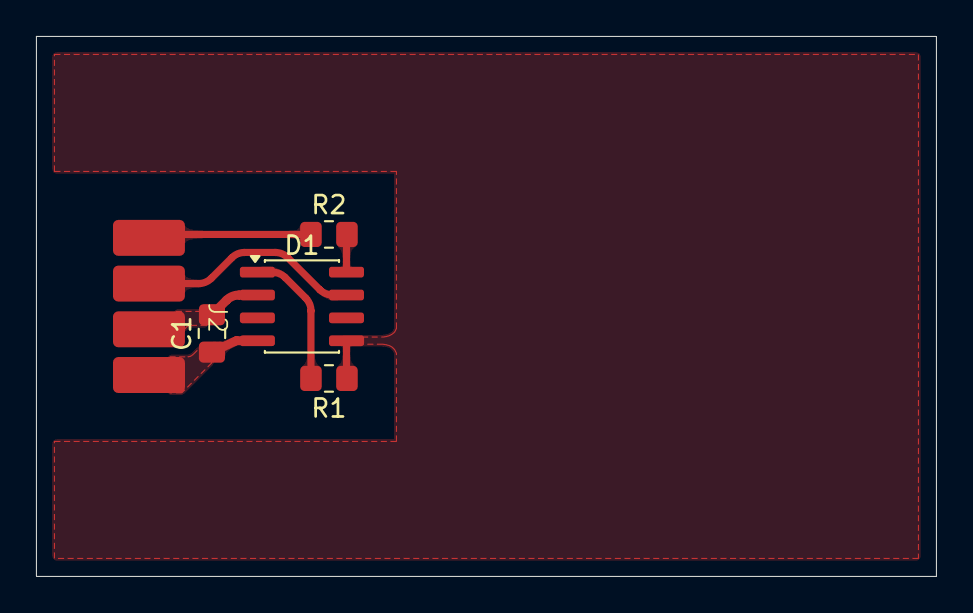
[picture p58: board water-sensor-ch32v003.kicad_pcb from above]

Board: 2 copper layers, 50.0 x 30.0 mm, 5 parts (0 on the bottom side), 7 nets.
