ElPudgino/LOS/scs-transmitter-pcb-v1/scs-transmiter-pcb-v1.kicad_pcb

## KiCad design scs-transmitter-pcb-v1/scs-transmiter-pcb-v1.kicad_pcb (2026-11-09)

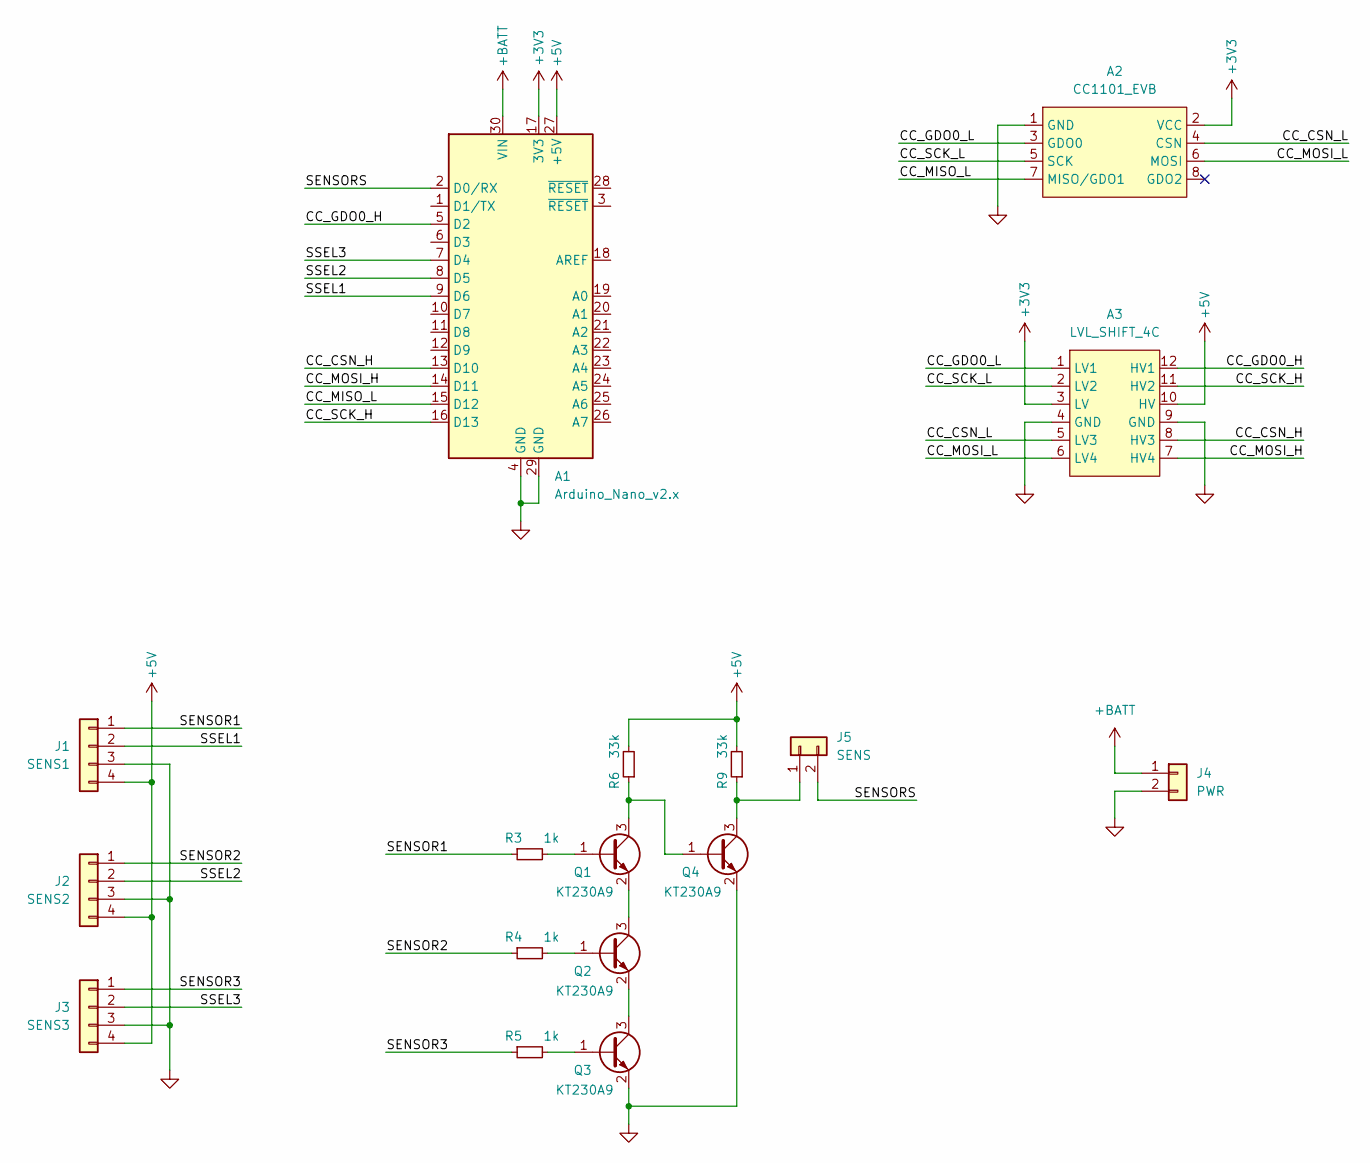
[picture p59: schematic scs-transmiter-pcb-v1.kicad_sch]

Parts:
A1: Arduino_Nano_v2.x; Arduino_Nano
A2: CC1101_EVB
A3: LVL_SHIFT_4C
J1: SENS1; PinHeader_1x04_P2.54mm_Vertical
J2: SENS2; PinHeader_1x04_P2.54mm_Vertical
J3: SENS3; PinHeader_1x04_P2.54mm_Vertical
J4: PWR; PinHeader_1x02_P2.54mm_Vertical
J5: SENS; PinHeader_1x02_P2.54mm_Vertical
Q1, Q2, Q3, Q4: КТ230А9; SOT-23
R3, R4, R5: 1k; R_0805_2012Metric_Pad1.20x1.40mm_HandSolder
R6, R9: 33k; R_0805_2012Metric_Pad1.20x1.40mm_HandSolder

Connections:
+3V3: A1.17 (3V3), A2.2 (VCC), A3.3 (LV)
+5V: A1.27 (+5V), A3.10 (HV), J1.4, J2.4, J3.4, R6.2, R9.2
+BATT: A1.30 (VIN), J4.1
/CC_CSN_H: A1.13 (D10), A3.8 (HV3)
/CC_CSN_L: A2.4 (CSN), A3.5 (LV3)
/CC_GDO0_H: A1.5 (D2), A3.12 (HV1)
/CC_GDO0_L: A2.3 (GDO0), A3.1 (LV1)
/CC_MISO_L: A1.15 (D12), A2.7 (MISO/GDO1)
/CC_MOSI_H: A1.14 (D11), A3.7 (HV4)
/CC_MOSI_L: A2.6 (MOSI), A3.6 (LV4)
/CC_SCK_H: A1.16 (D13), A3.11 (HV2)
/CC_SCK_L: A2.5 (SCK), A3.2 (LV2)
/SENSOR1: J1.1, R3.1
/SENSOR2: J2.1, R4.1
/SENSOR3: J3.1, R5.1
/SENSORS: A1.2 (D0/RX), J5.2
/SSEL1: A1.9 (D6), J1.2
/SSEL2: A1.8 (D5), J2.2
/SSEL3: A1.7 (D4), J3.2
GND: A1.4 (GND), A1.29 (GND), A2.1 (GND), A3.4 (GND), A3.9 (GND), J1.3, J2.3, J3.3, J4.2, Q3.2 (E), Q4.2 (E)
unnamed: J5.1, Q4.3 (C), R9.1
unnamed: Q1.1 (B), R3.2
unnamed: Q1.3 (C), Q4.1 (B), R6.1
unnamed: Q1.2 (E), Q2.3 (C)
unnamed: Q2.1 (B), R4.2
unnamed: Q2.2 (E), Q3.3 (C)
unnamed: Q3.1 (B), R5.2

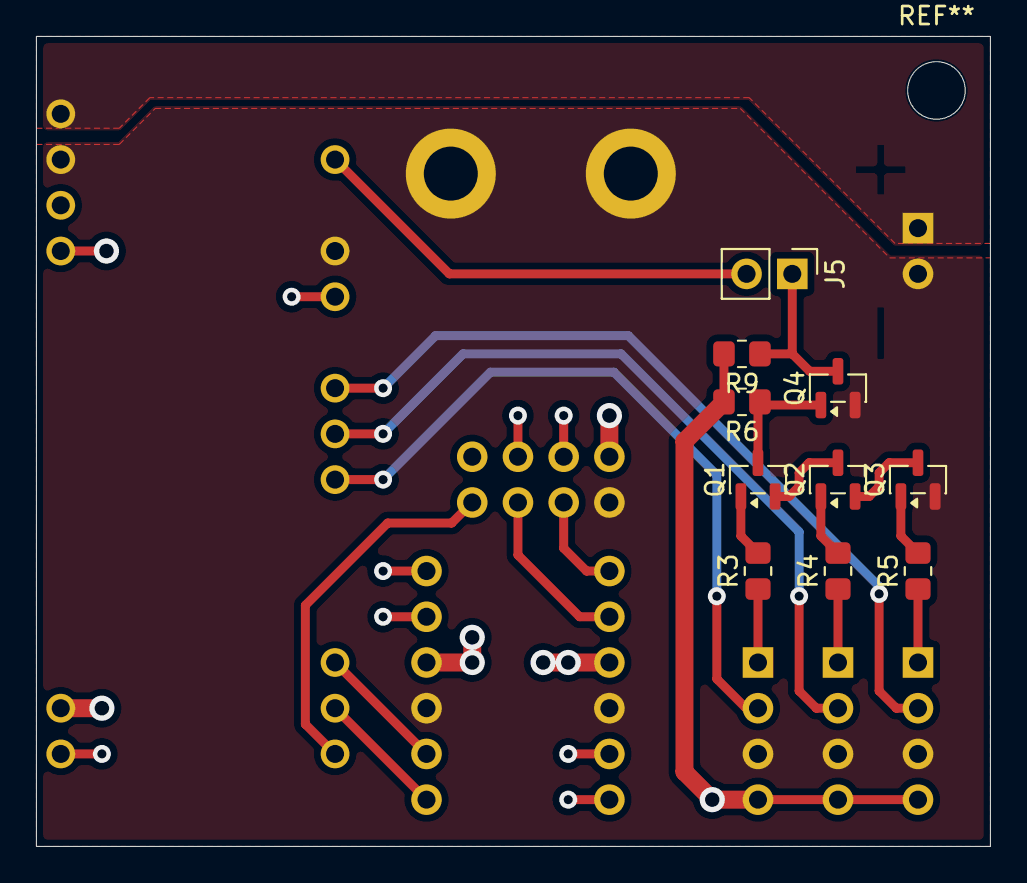
[picture p60: board scs-transmiter-pcb-v1.kicad_pcb from above]

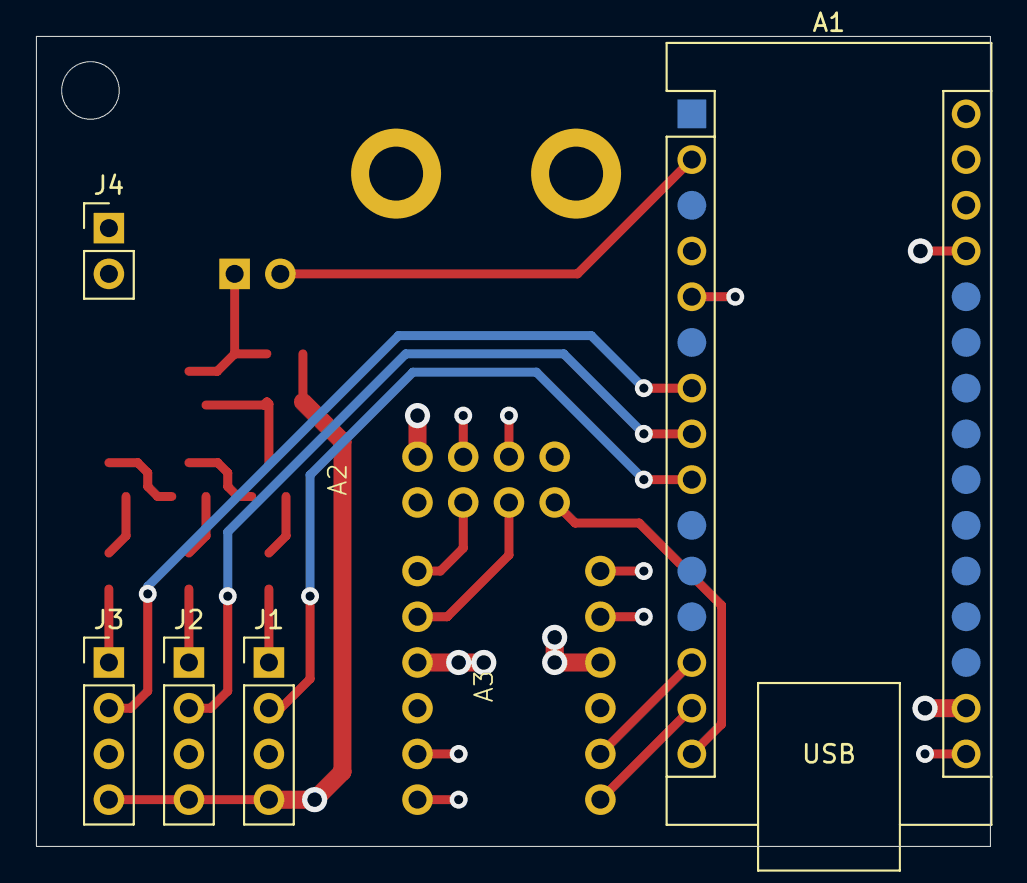
[picture p61: board scs-transmiter-pcb-v1.kicad_pcb from below]

Board: 2 copper layers, 53.0 x 45.0 mm, 17 parts (7 on the bottom side), 27 nets.
