ElPudgino/LOS/scs-stand-ps/stand-ps.kicad_pcb

## KiCad design scs-stand-ps/stand-ps.kicad_pcb (2026-11-09)

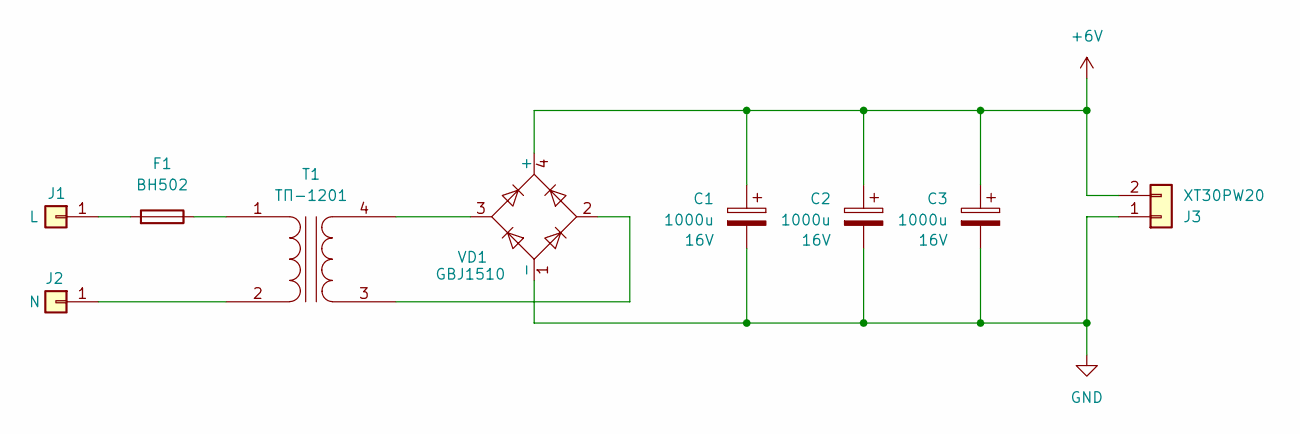
[picture p62: schematic stand-ps.kicad_sch]

Parts:
C1, C2, C3: 1000u; C_Radial_D10.0mm_H16.0mm_P5.00mm; Voltage 16V
F1: BH502
J1: L; TH3
J2: N; TH3
J3: XT30PW20; AMASS_XT30PW-M_1x02_P2.50mm_Horizontal
T1: ТП-1201; TP-1201
VD1: GBJ1510; Diode_Bridge_32.0x5.6x17.0mm_P10.0mm_P7.5mm

Connections:
+6V: C1.1, C2.1, C3.1, J3.2, VD1.4 (+)
GND: C1.2, C2.2, C3.2, J3.1, VD1.1 (-)
unnamed: F1.2, J1.1 (Pin_1_1)
unnamed: J2.1 (Pin_1_1), T1.2 (AB)
unnamed: F1.1, T1.1 (AA)
unnamed: T1.3 (SA), VD1.2
unnamed: T1.4 (SB), VD1.3

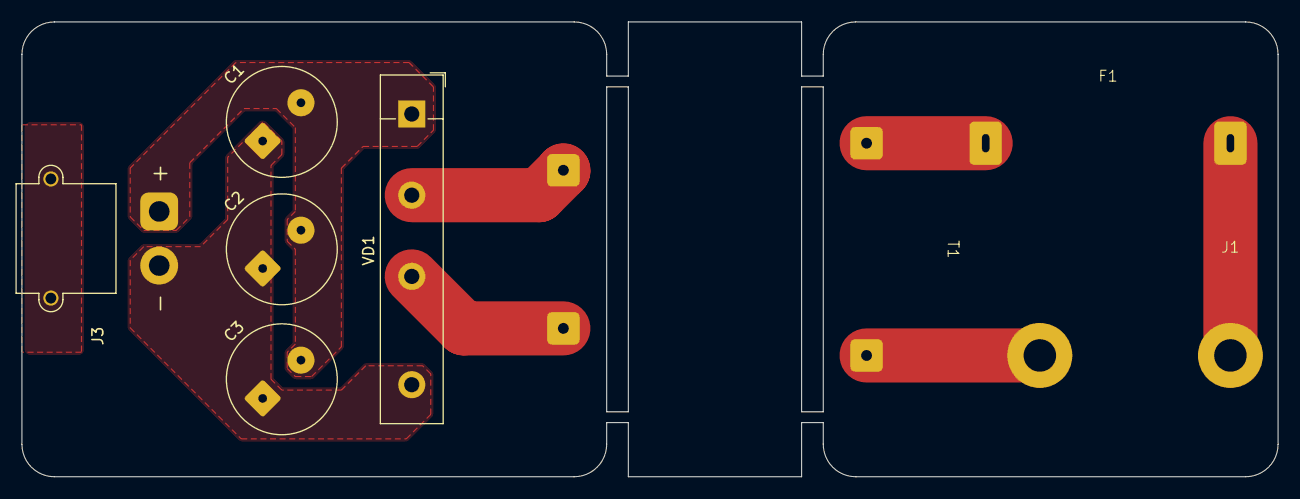
[picture p63: board stand-ps.kicad_pcb from above]

Board: 2 copper layers, 116.0 x 42.0 mm, 9 parts (0 on the bottom side), 7 nets.
