ElPudgino/LOS/scs-air-valve-pcb/air-valve-pcb.kicad_pcb

## KiCad design scs-air-valve-pcb/air-valve-pcb.kicad_pcb (2026-11-09)

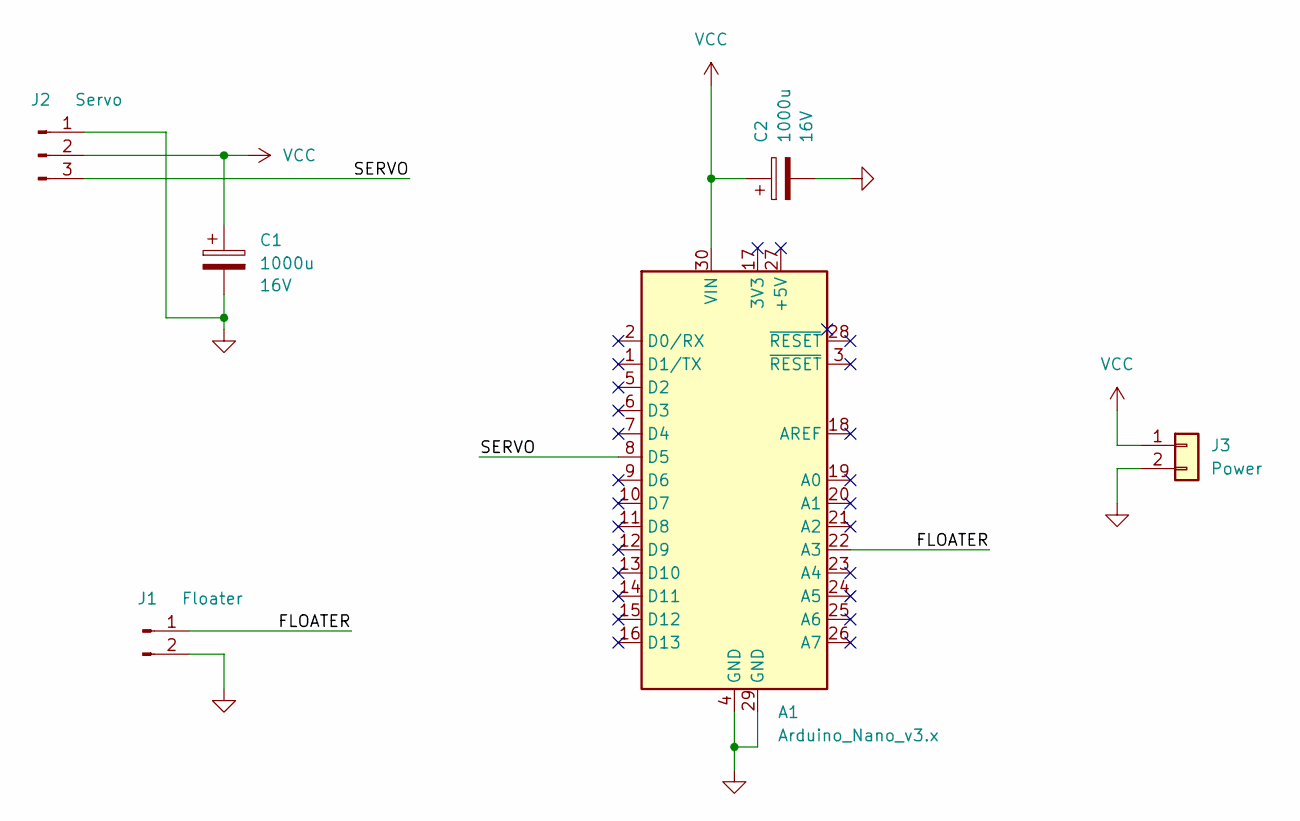
[picture p64: schematic air-valve-pcb.kicad_sch]

Parts:
A1: Arduino_Nano_v3.x; Arduino_Nano
C1, C2: 1000u; C_Radial_D10.0mm_H16.0mm_P5.00mm; Voltage 16V
J1: Floater; PinHeader_1x02_P2.54mm_Vertical
J2: Servo; PinHeader_1x03_P2.54mm_Vertical
J3: Power; AMASS_XT30PW-M_1x02_P2.50mm_Horizontal

Connections:
/FLOATER: A1.22 (A3), J1.1
/SERVO: A1.8 (D5), J2.3
GND: A1.4 (GND), A1.29 (GND), C1.2, C2.2, J1.2, J2.1, J3.2
VCC: A1.30 (VIN), C1.1, C2.1, J2.2, J3.1

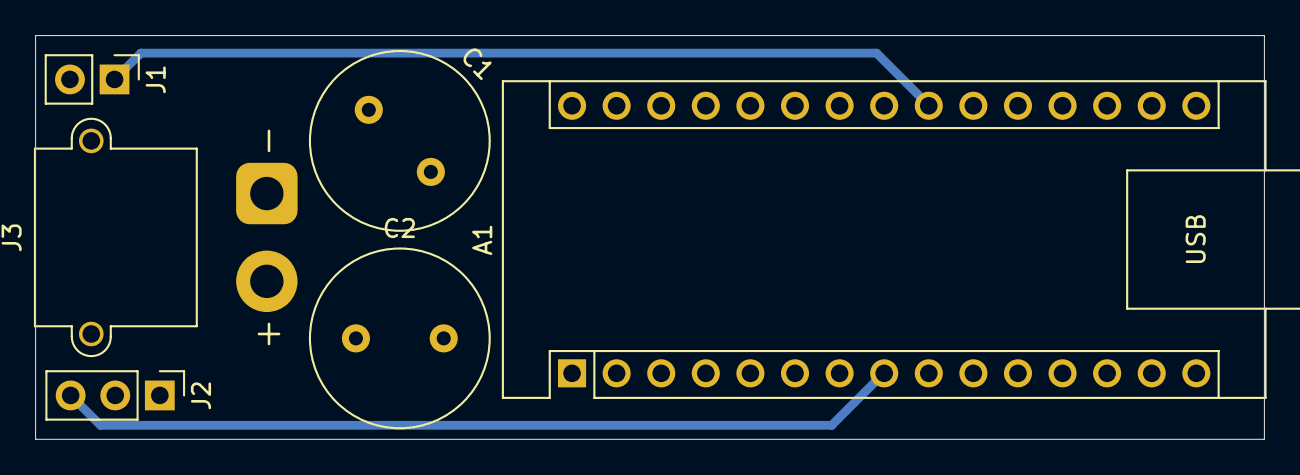
[picture p65: board air-valve-pcb.kicad_pcb from above]

Board: 2 copper layers, 70.0 x 23.0 mm, 6 parts (0 on the bottom side), 4 nets.
